netcodedev/LogicCircuit/ROADMAP_32BIT.md

# Roadmap: 32-Bit-RISC-V-SoC (`SOC_RV32`)

Ziel: ein 32-Bit-SoC mit dem Befehlssatz RISC-V RV32IM, gebaut aus denselben
Grundgattern wie `SOC_16B`, getrennt vom 8/16-Bit-Ökosystem (eigene
Schaltungen in `circuits/riscv/`, eigene Werkzeuge in `src/riscv/`, eigene
Programme in `programs/riscv/`). Gemeinsam genutzt werden nur die
breitenunabhängigen Grundbausteine in `src/circuits/` (`ADDER<W>`,
`REGISTER_R<W>`, `MUX_*_BUS<W>`, `PREFIX_LEVEL<W,D>`, ...). Der spätere
Ausbau auf 64 Bit (RV64I) wird mitgedacht: Bausteine mit Breitenparameter,
wo es geht.

## Entscheidungen (Phase 0, 2026-11-10)

Mit Ben besprochen und so angenommen:

1. **Befehlssatz:** RV32IM + Zicsr, ohne C-Erweiterung (16-Bit-Befehle
   machen Fetch und Decoder deutlich komplizierter; später optional).
2. **Register:** 32 × 32 Bit (volles RV32I, kein RV32E), x0 fest 0.
3. **Pipeline:** drei Stufen wie `SOC_16B` (Fetch | Execute | Memory) mit
   Forwarding, Load-Use-Stall und später Befehls-Cache. Das
   5-Stufen-Experiment des 16-Bit-SoC hat sich nicht gelohnt.
4. **Speicher:** ein gemeinsamer Bus (von Neumann) mit Byte-Adressen und
   Byte-Enables (`ByteEn[4]`). Fehlausgerichtete Zugriffe lösen eine
   Ausnahme aus (erlaubt laut Spezifikation, spart die Zerlegung in Hardware).
5. **Privilegien:** nur Machine-Mode mit minimalen CSRs (`mstatus`, `mie`,
   `mip`, `mtvec`, `mepc`, `mcause`, `mtval`, `mscratch`, `mcycle`,
   `minstret`, `misa`, `mhartid`) und einem Timer nach CLINT-Art
   (`mtime`/`mtimecmp`).
6. **Speicherkarte:** RAM ab `0x0000_0000`, Peripherie ab `0x1000_0000`
   (GPIO, Anzeige, UART, Timer), siehe unten.
7. **Toolchain:** eigener Assembler in Rust (läuft auch im Browser) und
   LLVM/Clang + lld als externe Abhängigkeit für C/Rust-Programme
   (`--target=riscv32 -march=rv32im_zicsr`).
8. **Chip-Flow:** zuerst weiter sky130 (direkter Vergleich mit `SOC_16B`),
   GF180MCU (wafer.space) als eigene spätere Phase.
9. **Namen:** `CPU_RV32` / `SOC_RV32` in `circuits/riscv/`.

Weitere Festlegungen (2026-11-10):

- **Halt:** `ebreak` hält die Maschine an (Ausgang `Halted`), statt eine
  Breakpoint-Ausnahme auszulösen – wie `HALT` beim 16-Bit-SoC.
- `wfi` und `fence` wirken wie `nop`.
- **Reset-Vektor** 0, `mtvec` nur direkt (Modus-Bits fest 0).
- `mcause` speichert Bit 31 und die Bits 3..0 (WLRL), `mepc`/`mtvec`
  Bits 31..2.
- Der Befehlssimulator zählt `mcycle` und `mtime` pro Befehl, die
  Schaltung pro Takt; Vergleiche lassen zeitabhängige Werte aus.

## Speicherkarte

| Adresse | Register | Zugriff |
|---|---|---|
| `0x0000_0000` | RAM (1 MiB im Runner, wiederholt sich) | lesen/schreiben |
| `0x1000_0000` | GPIO_OUT | lesen/schreiben |
| `0x1000_0004` | GPIO_IN | lesen |
| `0x1000_0008` | DISPLAY (8-stellige Hex-Anzeige) | lesen/schreiben |
| `0x1000_000C` | UART_DATA: schreiben sendet ein Byte, lesen holt das empfangene | lesen/schreiben |
| `0x1000_0010` | UART_STATUS: Bit 0 sendet gerade, Bit 1 Byte empfangen | lesen |
| `0x1000_0014` | UART_CTRL: Bit 0 Interrupt (extern) bei Empfang | lesen/schreiben |
| `0x1000_0018` | UART_DIV: Takte pro Bit - 1 (16 Bit, nach Reset 0) | lesen/schreiben |
| `0x1000_0020` / `_0024` | `mtime` (64 Bit, zählt Takte) | lesen/schreiben |
| `0x1000_0028` / `_002C` | `mtimecmp`; Timer-Interrupt, solange `mtime >= mtimecmp` | lesen/schreiben |

Die I/O-Register wiederholen sich alle 64 Byte im Bereich `0x1000_0000`–`0x1FFF_FFFF`
(IO_RV32 dekodiert nur die Adressbits 31..28 und 5..2). Ein Byte- oder
Halbwort-Store schreibt seine Bytes in ihre Spuren und 0 in die übrigen.
I/O-Lesezugriffe dauern zwei Takte (ein Wartetakt, das gelesene Register
wird zwischengespeichert), Schreibzugriffe einen.

## Phasen

### Phase 1 – Schneller Simulator (PR #6, 2026-11-10)
- [x] Flache Draht-Arrays, Flipflops als eingebaute Bausteine, topologische
      Sortierung: `SOC_16B` ~100 Hz → ~10 kHz

### Phase 2 – Werkzeuge in Rust (`src/riscv/`)
- [x] Befehlstabelle für Decoder, Encoder und Disassembler (`isa.rs`)
- [x] Assembler mit Pseudo-Befehlen und Direktiven (`asm.rs`), geprüft
      gegen LLVM (`clang --target=riscv32`), falls installiert
- [x] Befehlssimulator RV32IM + Zicsr mit Traps, Interrupts und der
      Peripherie der Speicherkarte (`sim.rs`)

### Phase 3 – Grundbausteine 32 Bit
- [x] Gemeinsam (mit Breitenparameter, in `src/circuits/`): `ADDER_KS5<W>`
      (Kogge-Stone, 5 Präfixstufen), `REG_FILE_32<W>` (x0 fest 0),
      `MUX_32_1_BUS<W>`, `DECODER_3_8`, `DECODER_5_32`
- [x] RISC-V-spezifisch (`circuits/riscv/`): `ALU_RV32` mit
      `SHIFTER_RV32`, `IMM_RV32`, `CONTROL_RV32` (Decoder, erkennt alle
      illegalen Befehle), `CSR_RV32`, `LSU_RV32` (Byte-Spuren),
      `MULDIV_RV32` (1 Bit pro Takt, 32 Schritte, Vorzeichen über Beträge)
- [x] Rust-Tests mit Zufallsvektoren gegen die Referenz (`src/riscv/tests.rs`)

### Phase 4 – CPU_RV32
- [x] Drei Stufen (Fetch \| Execute \| Memory), Forwarding aus der
      Memory-Stufe, Load-Use-Stall, ein Bus mit `Wait`
- [x] Traps (illegal, ecall, fehlausgerichtete Sprünge/Loads/Stores),
      Timer- und externer Interrupt, `mret`, `ebreak` hält an
- [x] M-Erweiterung über `MULDIV_RV32` (Execute wartet 32 Takte)
- [x] 101.020 NANDs (Registerdatei 50 %, CSRs 18 %, MulDiv 12 %),
      Logiktiefe 131 NAND-Stufen

### Phase 5 – SOC_RV32, Runner, Tests
- [x] `IO_RV32` (GPIO, Anzeige, UART mit `UART_TX`/`UART_RX`, `mtime`/
      `mtimecmp`), `SOC_RV32` mit Synchronizern und 8-stelliger Anzeige:
      123.293 NANDs
- [x] Runner `src/riscv/machine.rs` (RAM mit Byte-Enables, Wartezyklen,
      UART-Leitungen), `riscv asm/run/bench` in der CLI
- [x] Vergleich mit dem Befehlssimulator (`src/riscv/cpu_tests.rs`):
      Register, RAM, UART, Anzeige und GPIO gleich – gezielte Programme,
      Zufallsprogramme, langsamer Speicher, Timer- und UART-Interrupts
- [x] Programme in `programs/riscv/` (Assembler) und C über clang + lld
      (`programs/riscv/c/`: `crt0.s`, `link.ld`, `soc.h`)

### Phase 6 – Benchmarks, Viewer, Chip-Flow
- [x] `riscv bench` (`programs/riscv/bench/`), ohne Wartezyklen; das
      Ergebnis jedes Programms stimmt mit dem Befehlssimulator überein.
      Teuer sind der gemeinsame Bus (Loads/Stores halten den Fetch an) und
      die 33 Takte pro Multiplikation/Division.

| Programm | Befehle | Takte | CPI |
|---|---:|---:|---:|
| branch | 21.949 | 26.938 | 1,23 |
| calls | 20.713 | 31.563 | 1,52 |
| memory | 6.666 | 19.208 | 2,88 |
| muldiv | 6.904 | 112.262 | 16,26 |
| sieve (C) | 52.382 | 77.261 | 1,47 |
| sort | 7.897 | 13.730 | 1,74 |

- [x] Viewer: SOC_RV32 mit Beispielprogrammen, Listing mit
      Byte-Adressen, UART, Anzeige, GPIO
- [x] Simulation: SOC_RV32 läuft nativ mit etwa 6–18 kHz, im Browser
      mit etwa 1 kHz
- [ ] Chip-Flow (sky130) und Vergleich mit `SOC_16B`
- [x] `.clt`-Tests für alle RISC-V-Bausteine, `CPU_RV32` und `SOC_RV32`
      (für `verify-verilog`), aus dem Simulator erzeugt mit
      `cargo test --release --lib riscv::clt_gen -- --ignored`; CLT kann
      dafür ganze Busse setzen und prüfen (`SET A[31:0] 0x1234_5678`,
      `ASSERT S[31:0] -5`, `F[2:0] 0b101`)

### Phase 7 – Kürzerer kritischer Pfad
Gemessen als Logiktiefe in NAND-Stufen (wie `nands`), also ohne echte
Gatterlaufzeiten; ein sky130-Build steht noch aus.

| Schritt | Längster Pfad | `SOC_RV32` |
|---|---:|---:|
| Ausgangslage | 131 | 123.293 NANDs |
| Fehlausrichtung aus (rs1 + imm)[1:0], Branch über imm[1], `minstret` lädt bei Retire, CSR-Writes ohne ALU-Wartezeit | 98 | 123.329 |
| `MUX_2_1` als NAND-NAND (2 statt 4 Stufen, betrifft alle Schaltungen) | 84 | 100.945 |
| Eigener Vergleicher `BRANCH_RV32` aus rs1/rs2, Immediate-Formate direkt aus den Opcode-Bits, späte Branch-Exception am Ende der Exception-Kette | 69 | 102.206 |

- [x] Ergebnis: 131 → 69 Stufen (−47 %), 17 % weniger NANDs; `SOC_16B`
      sinkt durch den neuen Mux von 85 auf 64 Stufen
- [x] Die längsten Pfade sind jetzt ausgeglichen (65–69 Stufen): Decode →
      Load-Use-Stall → `XGo` → CSR-Schreiben, Branch-Vergleich → Redirect →
      `PC`, Trap → `mstatus`
- Shifter (17 Stufen) und Registerdatei-Lesen (14) liegen nicht mehr auf
  den längsten Pfaden; ein Umbau dort würde NANDs kosten, ohne den Takt zu
  heben
- [x] sky130-Build (`chip build SOC_RV32`, Basis-Blöcke, met5, 40 %):

  | | master | Phase 7 |
  |---|---:|---:|
  | fmax ohne `--optimize` (10 ns) | 28 MHz | 30 MHz |
  | fmax mit `--optimize` (7 ns) | 98 MHz | 131 MHz (+34 %) |
  | Transistoren (`--optimize`) | 188.897 | 192.901 |
  | + Shifter ohne Bit-Umkehr, `mtval` aus dem Addierer | | **134 MHz** (+37 %), 193.762 Transistoren |

  Ohne `--optimize` bestimmt der ungepufferte Fanout des Befehlsregisters
  (18 ns an einem Flipflop-Ausgang) den Takt. Mit `--optimize` lief der
  Pfad auf master über ALU-Ergebnis → Fehlausrichtung → Commit →
  `minstret`; jetzt über Registerdatei → Shifter → ALU-Mux → `mtval`.
  Auf Basis-Ebene wird `MUX_2_1` als `mux2`-Zelle exportiert, Schritt 3
  wirkt dort also nicht. Der Shifter (7 `mux2`-Stufen) lag in echten
  Zellen wieder auf dem kritischen Pfad; jetzt sind es Links- und
  Rechts-Shifter nebeneinander (5 Stufen, `SHIFT_STAGE_L`/`_R`), der
  ALU-Mux wählt. Danach sind die Pfade ausgeglichen: Branch-Vergleich →
  Trap/Redirect → `PC` (−0,48 ns) und Registerdatei → ALU → `ResultM`
  (−0,47 ns). Mehr Takt braucht einen Umbau der Pipeline (z. B. Redirect
  erst in der nächsten Stufe).

### Phase 8 – CPI und Fläche (aus der Untersuchung vom 11.11.2026)
Vier Recherche-Agenten haben Pipeline, Befehls-Cache, MulDiv/Sprungvorhersage
und Fläche untersucht (Prototypen). Umgesetzt sind die billigen Gewinne:

- [x] `INC_KS5<W>` (Inkrementierer) statt Addierer für `mcycle`/`minstret`,
      `mtime`, die Vorzeichen in `MULDIV_RV32` und PC + 4; `CMP_KS5<W>`
      (nur Übertrag) für `BRANCH_RV32` und `mtime >= mtimecmp`
- [x] `MULDIV_RV32` mit 2 Bit pro Takt (18 statt 34 Takte)
- [x] Statische Sprungvorhersage im Fetch: Rückwärtssprünge genommen,
      Vorwärtssprünge nicht, `jal` immer; Execute prüft nur die Richtung

| Programm | CPI vorher | CPI jetzt |
|---|---:|---:|
| branch | 1,23 | 1,02 |
| calls | 1,52 | 1,43 |
| memory | 2,88 | 2,04 |
| muldiv | 16,26 | 8,78 |
| sieve (C) | 1,47 | 1,26 |
| sort | 1,74 | 1,45 |

- [x] `SOC_RV32`: 102.406 → 99.430 NANDs; sky130 (`--optimize`, 7 ns):
      134 → 135 MHz, 193.762 → 183.531 Transistoren (−5 %), Die 689 → 667 µm
- [x] `--lib hs` (schnelle Zellen, Stand Phase 7): 143 MHz bei Die 787 µm
- [x] Registerdatei schon im Fetch lesen: rs1/rs2 landen mit dem Befehl in
      `OpA`/`OpB` (ein Write auf derselben Flanke wird umgeleitet, `HazR`
      merkt sich, was die Memory-Stufe noch weiterreichen muss)
- [x] Vor-Dekodierung im Fetch: `DECODE_RV32` (`CONTROL_RV32` + `IMM_RV32`
      in Registern), Execute bekommt alle Steuersignale aus Flipflops
- [x] `MTIP` registriert; I/O-Lesezugriffe mit einem Wartetakt (gelesenes
      Register zwischengespeichert), damit der I/O-Lese-Mux nicht vor dem
      Dekoder liegt; `Redirect` ohne die späte Branch-Exception
- [x] Ergebnis: 69 → 52 NAND-Stufen (`SOC_RV32`), 99.430 → 106.760 NANDs,
      CPI gleich (sieve 1,26 → 1,27 durch die I/O-Wartetakte); sky130
      (`--optimize`): 135 → **170 MHz** (+26 %, Ziel 5 ns;
      bei 6 ns wird das Ziel mit 167 MHz genau erreicht), 183.531 →
      193.292 Transistoren, Die 667 → 684 µm. Der längste Pfad ist jetzt
      ein Schritt von `MULDIV_RV32` (Ir → Radix-4-Schritt → `LoReg`),
      danach Forwarding → Branch-Vergleich → `PC`
- Weitere Prototypen (noch nicht übernommen): Registerdatei aus Latches
  (−27k NANDs, braucht Latch-Zellen und Timing-Constraints im Export),
  Befehls-Cache mit 32 Wörtern (+54k NANDs, bei 3 Wartetakten 2–3,5× schneller). Cache, Vorhersage und frühes
  Register-Lesen teilen sich den Fetch-Pfad: zusammen brauchen sie
  Vor-Dekodier-Bits im Cache oder eine eigene Fetch-Stufe.

### Später
- [ ] Befehls-Cache
- [ ] Schnellerer Multiplizierer (4 Bit pro Takt) und Division mit frühem Ende
- [ ] GF180MCU-Flow (wafer.space)
- [ ] RV64I
