netcodedev/LogicCircuit/src/main.rs

use clap::Parser;
use std::path::{Path, PathBuf};

use logic_circuit::cldl::CircuitBuilder;
use logic_circuit::clt::{CircuitTester, TestSummary}; // Import TestSummary
use logic_circuit::cldl::FlatLevel;
use logic_circuit::export::verilog::{CellLib, VerilogOptions, export_verilog};
use logic_circuit::export::verify_with_iverilog;
use logic_circuit::chip::{self, BuildOptions, RunMetrics};
use logic_circuit::isa::Isa;
use logic_circuit::isa::sim16::Cpu16;
use logic_circuit::{clt, machine, riscv};

#[derive(clap::ValueEnum, Clone, Copy, Debug)]
enum Level {
    /// Basic blocks (NOT, AND, OR, XOR, ...) as standard cells
    Basic,
    /// Everything as 2-input NAND cells
    Nand,
}

impl From<Level> for FlatLevel {
    fn from(l: Level) -> Self {
        match l {
            Level::Basic => FlatLevel::Basic,
            Level::Nand => FlatLevel::Nand,
        }
    }
}

#[derive(clap::ValueEnum, Clone, Copy, Debug)]
enum LibArg {
    /// sky130_fd_sc_hd: high density
    Hd,
    /// sky130_fd_sc_hs: high speed
    Hs,
}

#[derive(clap::ValueEnum, Clone, Copy, Debug)]
enum Cells {
    /// sky130_fd_sc_hd standard cells (for OpenROAD)
    Sky130,
    /// sky130_fd_sc_hs standard cells: high speed, larger
    Sky130Hs,
    /// Self-contained LC_* cell models (for Icarus Verilog / Verilator)
    Generic,
}

// --- Command Line Argument Parsing ---
#[derive(Parser, Debug)]
#[command(author, version, about, long_about = None)]
struct Args {
    #[command(subcommand)]
    command: Option<Commands>,

    /// Optional path to a directory containing additional .cldl circuit
    /// definitions AND/OR .clt test files. Searched recursively.
    /// If provided, definitions augment/override embedded ones, and
    /// the 'test' command ONLY runs tests from this directory.
    /// If not provided, 'test' command runs tests from src/circuits/.
    #[arg(short = 'd', long, value_name = "DIR")]
    directory: Option<PathBuf>,
}

#[derive(clap::Subcommand, Debug)]
enum Commands {
    /// Run circuit tests (.clt files).
    /// Runs tests either from the directory specified by -d
    /// or from src/circuits/ if -d is not provided.
    Test {
        /// Build every circuit from NAND gates only (the *_NAND definitions
        /// in place of the built-in gates), as a cross-check.
        #[arg(long)]
        nand: bool,
    },
    Export {
        #[arg(value_name = "COMPONENT_NAME")]
        component_name: String,
    },
    /// Assemble a program (.asm) and run it on a CPU circuit.
    /// Loads ./circuits automatically if -d is not given.
    Run {
        #[arg(value_name = "PROGRAM")]
        program: PathBuf,
        /// Circuit to run on (needs PC, CLK and Instruction or a memory bus).
        /// Default: COMPUTER_16B for programs in a directory named "16",
        /// SOC_16B in one named "soc", else COMPUTER_8B. The circuit's ports
        /// select the instruction set.
        #[arg(long)]
        top: Option<String>,
        /// Value on the input port `In` (decimal or 0x hex).
        #[arg(long, default_value = "0", value_parser = parse_word)]
        input: u16,
        /// Stop after this many instructions if the program does not HALT.
        #[arg(long, default_value_t = 10_000)]
        max_steps: usize,
        /// Print every executed instruction.
        #[arg(long)]
        trace: bool,
        /// Wait states per memory access, for CPUs with IWait/DWait ports
        /// (COMPUTER_16B_PIPE3); 0 = memories answer at once.
        #[arg(long, default_value_t = 0)]
        mem_latency: usize,
        /// Text to send to the UART receive line (SOC_16B); `\n` is a newline.
        #[arg(long, default_value = "")]
        uart_in: String,
    },
    /// Run the benchmarks in programs/bench: instructions on the
    /// instruction-level simulator, clocks on each 16-bit computer.
    /// Loads ./circuits automatically if -d is not given.
    Bench {
        /// Computers to run on, comma-separated.
        #[arg(long, default_value = "COMPUTER_16B,COMPUTER_16B_PIPE3,SOC_16B")]
        top: String,
        /// Wait states per memory access (see run --mem-latency).
        #[arg(long, default_value_t = 0)]
        mem_latency: usize,
        /// Only the instruction-level simulator (fast).
        #[arg(long)]
        isa_only: bool,
        /// Also show where the clocks go (computers with CPU_16B_SOC):
        /// executed instructions and the clocks lost, by cause.
        #[arg(long)]
        stalls: bool,
    },
    /// Count the NAND gates a circuit is built from, broken down by part.
    /// Without a name, lists every known circuit.
    /// Loads ./circuits automatically if -d is not given.
    Nands {
        #[arg(value_name = "COMPONENT_NAME")]
        component_name: Option<String>,
        /// How many hierarchy levels of parts to break down.
        #[arg(long, default_value_t = 1)]
        depth: usize,
    },
    /// Export a circuit as structural gate-level Verilog.
    /// Loads ./circuits automatically if -d is not given.
    ExportVerilog {
        #[arg(value_name = "COMPONENT_NAME")]
        component_name: String,
        #[arg(long, value_enum, default_value_t = Level::Basic)]
        level: Level,
        #[arg(long, value_enum, default_value_t = Cells::Sky130)]
        cells: Cells,
        /// Keep flip-flops as our latch gates instead of flip-flop cells.
        #[arg(long)]
        keep_latches: bool,
        /// Map 2:1 multiplexers (MUX_2_1) to multiplexer cells instead of
        /// their gates (basic level only; chip builds always do this).
        #[arg(long)]
        mux_cells: bool,
        /// Output file (default: <COMPONENT_NAME>.v).
        #[arg(short, long)]
        output: Option<PathBuf>,
        /// Also write a TSV mapping Verilog names back to wire keys / parts.
        #[arg(long, value_name = "FILE")]
        names: Option<PathBuf>,
    },
    /// The RISC-V SoC (SOC_RV32): assemble, run, benchmark.
    /// Loads ./circuits automatically if -d is not given.
    Riscv {
        #[command(subcommand)]
        command: RiscvCommand,
    },
    /// Chip layout: place and route with OpenROAD (Docker) and report.
    /// Loads ./circuits automatically if -d is not given.
    Chip {
        #[command(subcommand)]
        command: ChipCommand,
    },
    /// Check exported netlists against the .clt tests with Icarus Verilog.
    /// Without a name, checks every circuit that has tests.
    VerifyVerilog {
        #[arg(value_name = "COMPONENT_NAME")]
        component_name: Option<String>,
        #[arg(long, value_enum, default_value_t = Level::Basic)]
        level: Level,
        #[arg(long)]
        keep_latches: bool,
        /// Start every cell unknown (x), as after power-on, instead of at the
        /// simulator's state after building: passes only for suites whose
        /// tests reset first (e.g. SOC_16B, CPU_16B_SOC, CPU_16B_PIPE3).
        #[arg(long)]
        x_init: bool,
        /// Map 2:1 multiplexers to multiplexer cells, as chip builds do.
        #[arg(long)]
        mux_cells: bool,
    },
}
#[derive(clap::Subcommand, Debug)]
enum RiscvCommand {
    /// Print the listing of an assembly program (address, word, source).
    Asm {
        #[arg(value_name = "PROGRAM")]
        program: PathBuf,
    },
    /// Run a program (.s, or .c with clang + lld) on SOC_RV32 or the
    /// instruction-level simulator.
    Run {
        #[arg(value_name = "PROGRAM")]
        program: PathBuf,
        /// Circuit with CPU_RV32's bus (default SOC_RV32).
        #[arg(long)]
        top: Option<String>,
        /// Run on the instruction-level simulator instead of a circuit.
        #[arg(long)]
        iss: bool,
        /// Stop after this many clocks (instructions with --iss).
        #[arg(long, default_value_t = 1_000_000)]
        max: u64,
        /// Print the PC and instruction every clock.
        #[arg(long)]
        trace: bool,
        /// Wait states per memory access.
        #[arg(long, default_value_t = 0)]
        mem_latency: usize,
        /// Text to send to the UART; `\\n` is a newline.
        #[arg(long, default_value = "")]
        uart_in: String,
        /// Value on the GPIO inputs (decimal or 0x hex).
        #[arg(long, default_value = "0", value_parser = parse_u32)]
        gpio_in: u32,
    },
    /// Run the programs in programs/riscv/bench: instructions on the
    /// instruction-level simulator, clocks on each circuit.
    Bench {
        #[arg(long, default_value = "SOC_RV32")]
        top: String,
        #[arg(long, default_value = "programs/riscv/bench")]
        dir: PathBuf,
        #[arg(long, default_value_t = 0)]
        mem_latency: usize,
    },
}

#[derive(clap::Subcommand, Debug)]
enum ChipCommand {
    /// Export as sky130 netlist, then floorplan, place, clock tree and route.
    /// Results go to chip/<NAME>/<run>/ (run name from the options).
    Build {
        #[arg(value_name = "COMPONENT_NAME")]
        component_name: String,
        #[arg(long, value_enum, default_value_t = Level::Basic)]
        level: Level,
        #[arg(long)]
        keep_latches: bool,
        /// Highest metal layer for routing, power grid and pins.
        #[arg(long, default_value = "met5", value_parser = ["met2", "met3", "met4", "met5"])]
        max_layer: String,
        /// Clock period in ns for timing analysis.
        #[arg(long, default_value_t = 10.0)]
        clock_period: f64,
        /// Core utilisation in percent.
        #[arg(long, default_value_t = chip::DEFAULT_UTIL)]
        util: u32,
        /// Fixed die size in um instead of --util: "200" (square) or "160x225".
        #[arg(long, value_parser = parse_die_size)]
        die_size: Option<(f64, f64)>,
        /// Let OpenROAD buffer and resize cells (changes the netlist).
        #[arg(long)]
        optimize: bool,
        /// Access time in ns of the instruction and data memories outside the
        /// chip (PC -> Instruction, MemAddr -> MemDataIn, Addr -> DataIn);
        /// 0 = ideal memories.
        #[arg(long, default_value_t = 0.0)]
        mem_delay: f64,
        /// Standard cell library: hd (high density) or hs (high speed: larger
        /// cells, faster; the run name gets "-hs").
        #[arg(long, value_enum, default_value_t = LibArg::Hd)]
        lib: LibArg,
    },
    /// Combine DEF, LEF and cell GDS of a run into one layout file
    /// (default <run>/layout.bin) and check it: every exported cell placed,
    /// every signal net connected.
    Extract {
        #[arg(value_name = "COMPONENT_NAME")]
        component_name: String,
        /// Run to extract (default: basic-met5, else the first run).
        #[arg(long)]
        run: Option<String>,
        /// Output file.
        #[arg(short, long)]
        output: Option<PathBuf>,
        /// Also write the layout as JSON (large; for debugging).
        #[arg(long)]
        json: bool,
    },
    /// Draw the layout as an image: top view of chosen layers, or an
    /// isometric view of the stack (--iso). SVG or PNG.
    Render {
        #[arg(value_name = "COMPONENT_NAME")]
        component_name: String,
        #[arg(long)]
        run: Option<String>,
        /// Comma-separated layers (e.g. met1,met2) or "all".
        #[arg(long)]
        layers: Option<String>,
        /// Isometric view of the layer stack instead of the top view.
        #[arg(long)]
        iso: bool,
        /// Include the power grid (VDD/VSS).
        #[arg(long)]
        power: bool,
        /// Isometric: microns between layers.
        #[arg(long, default_value_t = 4.0)]
        explode: f64,
        /// Isometric: vertical exaggeration.
        #[arg(long, default_value_t = 4.0)]
        zscale: f64,
        /// Image width in pixels.
        #[arg(long, default_value_t = 1600)]
        width: u32,
        /// svg or png (default: from the output file name, else svg).
        #[arg(long, value_parser = ["svg", "png"])]
        format: Option<String>,
        /// Output file (default: <run>/<NAME>-top.svg / -iso.svg).
        #[arg(short, long)]
        output: Option<PathBuf>,
    },
    /// Place and route with our own tools (no OpenROAD/PDK): row placement
    /// with simulated annealing, maze routing with negotiated congestion.
    /// Writes chip/<NAME>/own-L<layers>/layout.bin.
    Route {
        #[arg(value_name = "COMPONENT_NAME")]
        component_name: String,
        /// Routing layers (2..5).
        #[arg(long, default_value_t = 3)]
        layers: i32,
        #[arg(long, value_enum, default_value_t = Level::Basic)]
        level: Level,
        #[arg(long)]
        keep_latches: bool,
        /// Core utilisation (0..1).
        #[arg(long, default_value_t = 0.7)]
        util: f64,
        /// Placement effort (annealing moves, relative).
        #[arg(long, default_value_t = 1.0)]
        effort: f64,
        /// Maximum negotiation iterations of the router.
        #[arg(long, default_value_t = 40)]
        iterations: usize,
    },
    /// Open the 3D view of a run in the browser (starts viz-serve if needed).
    View {
        #[arg(value_name = "COMPONENT_NAME")]
        component_name: String,
        #[arg(long)]
        run: Option<String>,
        #[arg(long, default_value_t = 8173)]
        port: u16,
        /// Only print the URL instead of opening a browser.
        #[arg(long)]
        no_open: bool,
    },
    /// Compare all runs of a circuit (or show one run in detail).
    Report {
        #[arg(value_name = "COMPONENT_NAME")]
        component_name: String,
        /// Show only this run, with its cell list.
        #[arg(long)]
        run: Option<String>,
        /// Print JSON instead of tables.
        #[arg(long)]
        json: bool,
    },
}
// --- End Command Line Args ---

fn main() {
    let args = Args::parse();

    // Step 1: Create builder (always loads all embedded circuits from src/circuits)
    println!("Initializing CircuitBuilder (loading embedded circuits)...");
    let mut builder = CircuitBuilder::new();

    // Step 2: Load additional circuits ONLY if -d is specified
    if let Some(dir_path) = args.directory.as_deref() {
        if !dir_path.exists() || !dir_path.is_dir() {
            // Make this a fatal error as the user explicitly provided a path
            eprintln!(
                "Error: Specified directory does not exist or is not a directory: {:?}",
                dir_path
            );
            std::process::exit(1);
        } else {
            println!(
                "Loading additional/override circuits from specified directory: {:?}",
                dir_path
            );
            if let Err(e) = builder.load_circuits_from_path(dir_path) {
                eprintln!("Error loading circuits from {:?}: {}", dir_path, e);
                std::process::exit(1); // Make it fatal
            }
        }
    }

    // The CPU circuits live in ./circuits, which is not embedded.
    if args.directory.is_none() && matches!(
        args.command,
        Some(
            Commands::Run { .. }
                | Commands::Bench { .. }
                | Commands::Nands { .. }
                | Commands::ExportVerilog { .. }
                | Commands::VerifyVerilog { .. }
                | Commands::Chip { .. }
                | Commands::Riscv { .. }
        )
    ) {
        let default_dir = Path::new("./circuits");
        if default_dir.is_dir() {
            if let Err(e) = builder.load_circuits_from_path(default_dir) {
                eprintln!("Error loading circuits from {:?}: {}", default_dir, e);
                std::process::exit(1);
            }
        }
    }

    // Step 3: Dispatch Command
    match args.command {
        Some(Commands::Test { nand }) => {
            let mut tester = CircuitTester::new();
            tester.nand = nand;
            let mut summary = TestSummary::new(); // Initialize summary
            let mut test_run_error = false;

            // Determine which directory to run tests in
            let test_dir_path = match args.directory.as_deref() {
                Some(p) => {
                    println!("Running tests specified in directory: {:?}", p);
                    p // Use the directory specified by -d
                }
                None => {
                    // -d not provided, default to src/circuits
                    let default_path = Path::new("./src/circuits");
                    println!("Running tests in default directory: {:?}", default_path);
                    default_path
                }
            };

            // Ensure the chosen test directory exists
            if !test_dir_path.exists() || !test_dir_path.is_dir() {
                eprintln!(
                    "Error: Test directory does not exist or is not a directory: {:?}",
                    test_dir_path
                );
                std::process::exit(1);
            }

            // Run tests using the determined path and the populated builder
            match tester.run_tests_in_dir(test_dir_path, &builder) {
                Ok(s) => summary = s, // Store the summary
                Err(e) => {
                    eprintln!("Test runner failed: {}", e);
                    test_run_error = true;
                    // summary remains default (0 passed, 0 failed)
                }
            }

            // Report final summary
            println!(
                "\nTest run finished: {} passed, {} failed.",
                summary.passed, summary.failed
            );
            if summary.failed > 0 || test_run_error {
                std::process::exit(1); // Exit with error code if tests failed or runner errored
            } else {
                println!("All specified tests passed! ✅");
                std::process::exit(0); // Exit successfully
            }
        }
        Some(Commands::Export { component_name }) => {
            println!("Exporting '{}' to DOT format...", component_name);
            
            // Generate the .dot string using the provided component name
            // Note: builder.export_to_dot will panic if the name is not found,
            // which is acceptable for this command-line tool.
            let dot_string = builder.export_to_dot(&component_name);
            
            // Create a dynamic filename, e.g., "ALU_4B.dot"
            let output_filename = format!("{}.dot", component_name);
            
            match std::fs::write(&output_filename, dot_string) {
                Ok(_) => println!("Successfully saved graph to '{}'", output_filename),
                Err(e) => eprintln!("Error saving .dot file: {}", e),
            }
        }
        Some(Commands::Run { program, top, input, max_steps, trace, mem_latency, uart_in }) => {
            let top = top.unwrap_or_else(|| {
                let in_dir = |name: &str| program.parent().is_some_and(|dir| dir.ends_with(name));
                if in_dir("16") {
                    "COMPUTER_16B"
                } else if in_dir("soc") {
                    "SOC_16B"
                } else {
                    "COMPUTER_8B"
                }
                .to_string()
            });
            run_program(&builder, &program, &top, input, max_steps, trace, mem_latency, &uart_in.replace("\\n", "\n"));
        }
        Some(Commands::Riscv { command }) => match command {
            RiscvCommand::Asm { program } => riscv::cli::asm(&program),
            RiscvCommand::Run { program, top, iss, max, trace, mem_latency, uart_in, gpio_in } => {
                let o = riscv::cli::RunOptions {
                    top,
                    iss,
                    max,
                    trace,
                    latency: mem_latency,
                    uart_in: uart_in.replace("\\n", "\n"),
                    gpio_in,
                };
                riscv::cli::run(&builder, &program, &o);
            }
            RiscvCommand::Bench { top, dir, mem_latency } => {
                let tops: Vec<&str> = top.split(',').map(str::trim).filter(|t| !t.is_empty()).collect();
                riscv::cli::bench(&builder, &dir, &tops, mem_latency);
            }
        },
        Some(Commands::Bench { top, mem_latency, isa_only, stalls }) => {
            let tops: Vec<&str> = if isa_only { Vec::new() } else { top.split(',').map(str::trim).collect() };
            run_bench(&builder, &tops, mem_latency, stalls);
        }
        Some(Commands::ExportVerilog { component_name, level, cells, keep_latches, mux_cells, output, names }) => {
            let opts = VerilogOptions {
                level: level.into(),
                cells: match cells {
                    Cells::Sky130 => CellLib::Sky130,
                    Cells::Sky130Hs => CellLib::Sky130Hs,
                    Cells::Generic => CellLib::Generic,
                },
                keep_latches,
                mux_cells,
            };
            let netlist = export_verilog(&builder, &component_name, &opts).unwrap_or_else(|e| {
                eprintln!("Error: {}", e);
                std::process::exit(1);
            });
            let path = output.unwrap_or_else(|| PathBuf::from(format!("{}.v", component_name)));
            if let Err(e) = std::fs::write(&path, &netlist.text) {
                eprintln!("Error writing {:?}: {}", path, e);
                std::process::exit(1);
            }
            let total: usize = netlist.cell_counts.values().sum();
            println!("\nWrote {} ({} cells)", path.display(), group_digits(total));
            for (cell, n) in &netlist.cell_counts {
                println!("  {:<28} {:>8}", cell, group_digits(*n));
            }
            if let Some(names_path) = names {
                let tsv: String = netlist.names.iter().map(|(v, k)| format!("{}\t{}\n", v, k)).collect();
                if let Err(e) = std::fs::write(&names_path, tsv) {
                    eprintln!("Error writing {:?}: {}", names_path, e);
                    std::process::exit(1);
                }
                println!("Wrote name map {}", names_path.display());
            }
        }
        Some(Commands::Chip { command }) => match command {
            ChipCommand::Build { component_name, level, keep_latches, max_layer, clock_period, util, die_size, optimize, mem_delay, lib } => {
                let opts = BuildOptions {
                    level: level.into(),
                    library: match lib {
                        LibArg::Hd => chip::Library::Hd,
                        LibArg::Hs => chip::Library::Hs,
                    },
                    keep_latches,
                    max_layer,
                    clock_period_ns: clock_period,
                    utilization: util,
                    die_size_um: die_size,
                    optimize,
                    mem_delay_ns: mem_delay,
                };
                println!("\nBuilding chip/{}/{} with OpenROAD …", component_name, opts.run_name());
                let started = std::time::Instant::now();
                match chip::build(&builder, &component_name, &opts, Path::new(".")) {
                    Ok(m) => {
                        println!("Done in {:.0} s.", started.elapsed().as_secs_f64());
                        print_chip_runs(&component_name, &[m]);
                    }
                    Err(e) => {
                        eprintln!("Error: {}", e);
                        std::process::exit(1);
                    }
                }
            }
            ChipCommand::Extract { component_name, run, output, json } => {
                if let Err(e) = chip_extract(&component_name, run.as_deref(), output, json) {
                    eprintln!("Error: {}", e);
                    std::process::exit(1);
                }
            }
            ChipCommand::Render { component_name, run, layers, iso, power, explode, zscale, width, format, output } => {
                let r = chip_render(&component_name, run.as_deref(), layers.as_deref(), iso, power, explode, zscale, width, format, output);
                if let Err(e) = r {
                    eprintln!("Error: {}", e);
                    std::process::exit(1);
                }
            }
            ChipCommand::Route { component_name, layers, level, keep_latches, util, effort, iterations } => {
                let opts = logic_circuit::pnr::Options {
                    level: level.into(),
                    keep_latches,
                    layers,
                    utilization: util,
                    effort,
                    max_iterations: iterations,
                    ..Default::default()
                };
                if let Err(e) = chip_route(&builder, &component_name, &opts) {
                    eprintln!("Error: {}", e);
                    std::process::exit(1);
                }
            }
            ChipCommand::View { component_name, run, port, no_open } => {
                if let Err(e) = chip_view(&component_name, run.as_deref(), port, no_open) {
                    eprintln!("Error: {}", e);
                    std::process::exit(1);
                }
            }
            ChipCommand::Report { component_name, run, json } => {
                let mut runs = chip::runs(Path::new("."), &component_name);
                if let Some(r) = &run {
                    runs.retain(|m| &m.run == r);
                }
                if runs.is_empty() {
                    eprintln!("No chip runs found for '{}' (chip build {} first).", component_name, component_name);
                    std::process::exit(1);
                }
                if json {
                    println!("{}", chip::to_json(&component_name, &runs));
                } else {
                    print_chip_runs(&component_name, &runs);
                    if run.is_some() {
                        print_chip_cells(&runs[0]);
                    }
                }
            }
        },
        Some(Commands::VerifyVerilog { component_name, level, keep_latches, x_init, mux_cells }) => {
            let opts = VerilogOptions { level: level.into(), cells: CellLib::Generic, keep_latches, mux_cells };
            verify_verilog(&builder, component_name.as_deref(), opts, x_init);
        }
        Some(Commands::Nands { component_name, depth }) => match component_name {
            Some(name) => print_nand_breakdown(&builder, &name, depth),
            None => print_nand_table(&builder),
        },
        None => {
            println!("\nNo command specified. Use 'test' or 'manual-test'.");
            println!("Use '-d <DIR>' to specify an additional directory for circuits and tests.");
            println!("Use '--help' for more options.");
        }
    }
}

/// Parses a 16-bit value given as decimal or `0x` hex.
fn parse_u32(text: &str) -> Result<u32, String> {
    match text.strip_prefix("0x").or_else(|| text.strip_prefix("0X")) {
        Some(hex) => u32::from_str_radix(hex, 16),
        None => text.parse(),
    }
    .map_err(|e| format!("expected a 32-bit number: {e}"))
}

fn parse_word(text: &str) -> Result<u16, String> {
    match text.strip_prefix("0x").or_else(|| text.strip_prefix("0X")) {
        Some(hex) => u16::from_str_radix(hex, 16),
        None => text.parse(),
    }
    .map_err(|e| format!("expected a 16-bit number: {e}"))
}

/// Runs every program in ./programs/bench on the instruction-level
/// simulator (instructions, expected Out) and on each computer in `tops`
/// (clocks; Out must match). Prints clocks and clocks per instruction.
fn run_bench(builder: &CircuitBuilder, tops: &[&str], latency: usize, stalls: bool) {
    let mut files: Vec<_> = std::fs::read_dir("./programs/bench")
        .map(|d| d.filter_map(|e| e.ok()).map(|e| e.path()).filter(|p| p.extension().is_some_and(|x| x == "asm")).collect())
        .unwrap_or_default();
    files.sort();
    if files.is_empty() {
        eprintln!("No benchmarks in ./programs/bench.");
        std::process::exit(1);
    }
    for top in tops {
        if builder.describe(top).is_none() {
            eprintln!("Circuit '{}' not found.", top);
            std::process::exit(1);
        }
    }
    print!("\n  {:<10} {:>8} {:>7}", "Benchmark", "Out", "Instr");
    for top in tops {
        print!("  {:>20}", top);
    }
    println!();
    let mut total_instr = 0u64;
    let mut hw_instr = 0u64;
    let mut total_clocks = vec![0usize; tops.len()];
    // Per computer: (benchmark, profile) and the sum, when --stalls.
    let mut profiles: Vec<Vec<(String, u64, logic_circuit::stalls::Profile)>> = vec![Vec::new(); tops.len()];
    let mut mismatch = false;
    for path in &files {
        let name = path.file_stem().unwrap().to_string_lossy();
        let src = std::fs::read_to_string(path).unwrap_or_default();
        let words = match Isa::Cpu16.assemble(&src) {
            Ok(p) => p.words,
            Err(e) => {
                eprintln!("{}:{}", path.display(), e);
                std::process::exit(1);
            }
        };
        let mut cpu = Cpu16::new(&words);
        cpu.run(10_000_000);
        total_instr += cpu.steps;
        if name.ends_with("_hw") {
            hw_instr += cpu.steps;
        }
        print!("  {:<10} {:>8} {:>7}", name, format!("0x{:04X}", cpu.out), cpu.steps);
        for (i, top) in tops.iter().enumerate() {
            // "*_hw" benchmarks need the multiply/divide unit (CPU_16B_SOC).
            if name.ends_with("_hw") && !has_muldiv(builder, top) {
                print!("  {:>20}", "–");
                continue;
            }
            let circuit = builder.build(top);
            let mut m = machine::Machine::new(&circuit).expect("not runnable");
            m.rom = words.clone();
            m.input = Some(0);
            m.latency = latency;
            m.reset(&circuit);
            let profile = if stalls { logic_circuit::stalls::run_profiled(&mut m, &circuit, 1_000_000) } else { None };
            let clocks = match &profile {
                Some(p) => p.clocks,
                None => m.run(&circuit, 1_000_000),
            };
            if let Some(p) = profile {
                profiles[i].push((name.to_string(), cpu.steps, p));
            }
            let out = machine::read_bus(&circuit, machine::OUT, 16) as u16;
            let ok = machine::halted(&circuit) && out == cpu.out;
            mismatch |= !ok;
            total_clocks[i] += clocks;
            let cell = format!("{} ({:.2}){}", clocks, clocks as f64 / cpu.steps as f64, if ok { "" } else { " ≠" });
            print!("  {:>20}", cell);
            use std::io::Write as _;
            let _ = std::io::stdout().flush();
        }
        println!();
    }
    print!("  {:<10} {:>8} {:>7}", "total", "", total_instr);
    for (i, c) in total_clocks.iter().enumerate() {
        let instr = if has_muldiv(builder, tops[i]) { total_instr } else { total_instr - hw_instr };
        print!("  {:>20}", format!("{} ({:.2})", c, *c as f64 / instr as f64));
    }
    println!();
    if !tops.is_empty() {
        println!("\n  Instr: instructions (instruction-level simulator); per computer: clocks (clocks per instruction)");
        println!("  –: needs the multiply/divide unit (CPU_16B_SOC); totals leave these out");
    }
    for (top, runs) in tops.iter().zip(&profiles) {
        if !runs.is_empty() {
            print_stalls(top, runs);
        }
    }
    if mismatch {
        println!("\n≠: wrong Out or no HALT (expected the instruction-level result).");
        std::process::exit(1);
    }
}

/// Table of `bench --stalls`: per benchmark the clocks, the clocks in
/// which execute ran an instruction, and the lost clocks by cause.
fn print_stalls(top: &str, runs: &[(String, u64, logic_circuit::stalls::Profile)]) {
    use logic_circuit::stalls::{Loss, Profile};
    let mut total = Profile::default();
    for (_, _, p) in runs {
        total.add(p);
    }
    let instr: u64 = runs.iter().map(|r| r.1).sum();
    println!("\n  Where the clocks go on {top}:\n");
    print!("  {:<22}", "");
    for (name, _, _) in runs {
        print!(" {:>8}", name);
    }
    println!(" {:>8} {:>7}", "total", "share");
    let row = |label: &str, f: &dyn Fn(&Profile) -> usize| {
        print!("  {:<22}", label);
        for (_, _, p) in runs {
            print!(" {:>8}", f(p));
        }
        let t = f(&total);
        println!(" {:>8} {:>6.1}%", t, 100.0 * t as f64 / total.clocks.max(1) as f64);
    };
    row("clocks", &|p| p.clocks);
    row("instructions executed", &|p| p.executed);
    for loss in Loss::ALL {
        if total.lost(loss) > 0 {
            row(&format!("  {}", loss.label()), &|p| p.lost(loss));
        }
    }
    row("(branches predicted)", &|p| p.predicted);
    if total.executed as u64 != instr {
        println!("\n  Note: executed {} ≠ {} instructions of the instruction-level simulator.", total.executed, instr);
    }
}

/// True if `top` contains the multiply/divide unit (a CPU_16B_SOC).
fn has_muldiv(builder: &CircuitBuilder, top: &str) -> bool {
    fn find(builder: &CircuitBuilder, name: &str, depth: usize) -> bool {
        name == "MULDIV_16B"
            || depth > 0
                && builder.describe(name).is_some_and(|v| v.parts.iter().any(|p| find(builder, &p.part_type, depth - 1)))
    }
    find(builder, top, 3)
}

fn run_program(
    builder: &CircuitBuilder,
    path: &Path,
    top: &str,
    input: u16,
    max_steps: usize,
    trace: bool,
    latency: usize,
    uart_in: &str,
) {
    let source = std::fs::read_to_string(path).unwrap_or_else(|e| {
        eprintln!("Error reading {:?}: {}", path, e);
        std::process::exit(1);
    });
    if builder.describe(top).is_none() {
        eprintln!("Circuit '{}' not found (use -d to load its directory).", top);
        std::process::exit(1);
    }

    let circuit = builder.build(top);
    let Some(mut machine) = machine::Machine::new(&circuit) else {
        eprintln!("Circuit '{}' has no PC/Instruction/CLK ports.", top);
        std::process::exit(1);
    };
    let isa = machine.isa();
    let program = isa.assemble(&source).unwrap_or_else(|e| {
        eprintln!("{}:{}", path.display(), e);
        std::process::exit(1);
    });
    machine.rom = program.words;
    machine.input = Some(input);
    machine.latency = latency;
    machine.uart_in.extend(uart_in.bytes());
    machine.reset(&circuit);
    // Hex digits of the PC and of Out.
    let pc_digits = machine.pc_width().div_ceil(4);
    let out_width = machine::bus_width(&circuit, machine::OUT);
    let out_digits = out_width.div_ceil(4).max(1);
    println!("\nRunning {} ({} words) on {}", path.display(), machine.rom.len(), top);

    machine.fetch(&circuit);
    let mut steps = 0;
    let started = std::time::Instant::now();
    // Time spent printing the trace is not simulation time.
    let mut trace_time = std::time::Duration::ZERO;
    while steps < max_steps && !machine::halted(&circuit) {
        let pc = machine.pc(&circuit);
        let word = machine.word_at(pc);
        machine.step(&circuit);
        steps += 1;
        if trace {
            let t = std::time::Instant::now();
            println!(
                "  [{:4}] PC={:0pw$X}  {:04X}  {:<18} Out={:0ow$X}",
                steps,
                pc,
                word,
                isa.disassemble_at(&machine.rom, pc),
                machine::read_bus(&circuit, machine::OUT, out_width),
                pw = pc_digits,
                ow = out_digits,
            );
            trace_time += t.elapsed();
        }
    }
    let elapsed = started.elapsed().saturating_sub(trace_time);

    let out = machine::read_bus(&circuit, machine::OUT, out_width);
    if machine::halted(&circuit) {
        println!("Halted after {} instructions at PC={:0w$X}.", steps, machine.pc(&circuit), w = pc_digits);
    } else {
        println!("Stopped after {} instructions (no HALT, see --max-steps).", steps);
    }
    println!("Out = 0x{:0w$X} ({})", out, out, w = out_digits);
    if machine::bus_width(&circuit, "GpioOut") > 0 {
        println!("GpioOut = 0x{:04X}", machine::read_bus(&circuit, "GpioOut", 16));
    }
    if !machine.uart.is_empty() {
        println!("UART: {:?}", String::from_utf8_lossy(&machine.uart));
    }
    let secs = elapsed.as_secs_f64();
    let rate = if secs > 0.0 { steps as f64 / secs } else { 0.0 };
    let rate = if rate >= 1000.0 { format!("{:.1} kHz", rate / 1000.0) } else { format!("{:.0} Hz", rate) };
    println!("Time = {:.1} ms for {} instructions (≈ {})", secs * 1000.0, steps, rate);

    // Show the 7-segment outputs if the circuit has them (highest digit first).
    let digits: Vec<u32> = ["Seg3", "Seg2", "Seg1", "Seg0"]
        .iter()
        .filter(|name| circuit.has_wire(&format!("{}.0", name)))
        .map(|name| machine::read_bus(&circuit, name, 7))
        .collect();
    if !digits.is_empty() {
        let seg = |d: u32, i: u32, on: char| if (d >> i) & 1 == 1 { on } else { ' ' };
        let rows = [
            digits.iter().map(|&d| format!(" {} ", seg(d, 0, '_'))).collect::<Vec<_>>(),
            digits.iter().map(|&d| format!("{}{}{}", seg(d, 5, '|'), seg(d, 6, '_'), seg(d, 1, '|'))).collect(),
            digits.iter().map(|&d| format!("{}{}{}", seg(d, 4, '|'), seg(d, 3, '_'), seg(d, 2, '|'))).collect(),
        ];
        println!();
        for row in rows {
            println!("    {}", row.join(" "));
        }
    }
}

/// Formats a count with thousands separators, e.g. 12,345.
fn group_digits(n: usize) -> String {
    let digits = n.to_string();
    let mut out = String::new();
    for (i, c) in digits.chars().enumerate() {
        if i > 0 && (digits.len() - i) % 3 == 0 {
            out.push(',');
        }
        out.push(c);
    }
    out
}

fn print_nand_table(builder: &CircuitBuilder) {
    let mut rows: Vec<(String, usize)> = builder
        .circuit_names()
        .into_iter()
        .filter_map(|name| builder.nand_count(&name).map(|n| (name, n)))
        .collect();
    rows.sort_by(|a, b| b.1.cmp(&a.1).then_with(|| a.0.cmp(&b.0)));
    println!("\n  {:<20} {:>10}", "Circuit", "NANDs");
    for (name, n) in rows {
        println!("  {:<20} {:>10}", name, group_digits(n));
    }
}

fn print_nand_breakdown(builder: &CircuitBuilder, name: &str, depth: usize) {
    let Some(total) = builder.nand_count(name) else {
        eprintln!("Circuit '{}' not found (use -d to load its directory).", name);
        std::process::exit(1);
    };
    println!("\n{}: {} NANDs", name, group_digits(total));
    let built = builder.build(name);
    println!(
        "Simulated as {} built-in gates (NOT, AND, OR, XOR, ...; see src/circuit/gates.rs) and {} flip-flops",
        group_digits(built.gate_count()),
        group_digits(built.flop_count())
    );
    if let Some(d) = builder.logic_depth(name) {
        println!("Logic depth: {} NAND levels (longest path between inputs/flip-flops and outputs/flip-flops)", d);
    }
    println!();
    println!("  {:<32} {:<18} {:>10} {:>7}", "Part", "Type", "NANDs", "Share");
    print_parts(builder, name, total, 1, depth);
}

fn print_parts(builder: &CircuitBuilder, name: &str, total: usize, level: usize, depth: usize) {
    let Some(view) = builder.describe(name) else { return };
    let mut parts = view.parts;
    parts.sort_by(|a, b| b.nand_count.cmp(&a.nand_count));
    for part in parts {
        let label = format!("{}{}", "  ".repeat(level - 1), part.instance_name);
        let share = 100.0 * part.nand_count as f64 / total.max(1) as f64;
        println!(
            "  {:<32} {:<18} {:>10} {:>6.1}%",
            label,
            part.part_type,
            group_digits(part.nand_count),
            share
        );
        if level < depth && part.expandable {
            print_parts(builder, &part.part_type, total, level + 1, depth);
        }
    }
}

/// Collects all .clt test suites below the given directories.
fn collect_suites(dirs: &[&Path]) -> Vec<clt::CltTestSuite> {
    fn walk(dir: &Path, out: &mut Vec<clt::CltTestSuite>) {
        let Ok(entries) = std::fs::read_dir(dir) else { return };
        let mut paths: Vec<PathBuf> = entries.flatten().map(|e| e.path()).collect();
        paths.sort();
        for path in paths {
            if path.is_dir() {
                walk(&path, out);
            } else if path.extension().is_some_and(|e| e == "clt") {
                match std::fs::read_to_string(&path).map_err(|e| e.to_string()).and_then(|s| clt::parse_clt(&s)) {
                    Ok(file) => out.extend(file.suites),
                    Err(e) => eprintln!("Skipping {:?}: {}", path, e),
                }
            }
        }
    }
    let mut out = Vec::new();
    for dir in dirs {
        walk(dir, &mut out);
    }
    out
}

fn verify_verilog(builder: &CircuitBuilder, only: Option<&str>, opts: VerilogOptions, x_init: bool) {
    let suites: Vec<_> = collect_suites(&[Path::new("./src/circuits"), Path::new("./circuits")])
        .into_iter()
        .filter(|s| only.is_none_or(|n| s.circuit_name == n))
        .collect();
    if suites.is_empty() {
        eprintln!("No .clt tests found{}.", only.map(|n| format!(" for '{}'", n)).unwrap_or_default());
        std::process::exit(1);
    }
    let work = std::env::temp_dir().join("logiccircuit-verify");
    println!("\nVerifying exported netlists with Icarus Verilog (work dir {})", work.display());
    println!("  {:<20} {:>7} {:>9} {:>8}", "Circuit", "Checks", "Failures", "Skipped");
    let mut failed = 0;
    for suite in &suites {
        match verify_with_iverilog(builder, suite, opts, x_init, &work) {
            Ok(r) => {
                let mark = if r.failures.is_empty() { "✅" } else { "❌" };
                println!(
                    "  {:<20} {:>7} {:>9} {:>8}  {}",
                    suite.circuit_name,
                    r.checks,
                    r.failures.len(),
                    r.skipped.len(),
                    mark
                );
                for f in r.failures.iter().take(5) {
                    println!("      {}", f);
                }
                if !r.failures.is_empty() {
                    failed += 1;
                }
            }
            Err(e) => {
                println!("  {:<20} error: {}", suite.circuit_name, e.lines().next().unwrap_or(""));
                failed += 1;
            }
        }
    }
    if failed > 0 {
        println!("\n{} of {} suites failed.", failed, suites.len());
        std::process::exit(1);
    }
    println!("\nAll {} suites match our simulator.", suites.len());
}

fn print_chip_runs(name: &str, runs: &[RunMetrics]) {
    let fmt_f = |v: f64| group_digits(v.round() as usize);
    println!("\n{}\n", name);
    println!(
        "  {:<24} {:>13} {:>11} {:>8} {:>12} {:>10} {:>8} {:>4} {:>8} {:>9}",
        "Run", "Die (um)", "Logic um2", "Cells", "Transistors", "Wire um", "Vias", "DRC", "Slack", "fmax"
    );
    for r in runs {
        let cells = match r.exported_cells {
            Some(e) if e != r.logic_cells() => format!("{}*", group_digits(r.logic_cells())),
            _ => group_digits(r.logic_cells()),
        };
        println!(
            "  {:<24} {:>13} {:>11} {:>8} {:>12} {:>10} {:>8} {:>4} {:>8} {:>9}",
            r.run,
            format!("{:.0} x {:.0}", r.die_um.0, r.die_um.1),
            fmt_f(r.logic_area_um2),
            cells,
            group_digits(r.transistors),
            fmt_f(r.total_wire_um()),
            r.vias.map_or("-".into(), group_digits),
            r.drc_violations,
            r.worst_slack_ns.map_or("-".into(), |v| format!("{:.2} ns", v)),
            r.fmax_mhz().map_or("-".into(), |v| format!("{:.0} MHz", v)),
        );
    }
    if runs.iter().any(|r| r.exported_cells.is_some_and(|e| e != r.logic_cells())) {
        println!("  * more cells than exported: clock tree buffers (and buffers from --optimize)");
    }

    // Wire length per layer, one column per run.
    let layers: Vec<&str> = chip::LAYERS.to_vec();
    print!("\n  {:<6}", "Wire");
    for r in runs {
        print!(" {:>24}", r.run);
    }
    println!();
    for layer in layers {
        print!("  {:<6}", layer);
        for r in runs {
            let v = r.wire_um.get(layer).copied().unwrap_or(0.0);
            let share = 100.0 * v / r.total_wire_um().max(1.0);
            print!(" {:>24}", format!("{} um ({:.0}%)", fmt_f(v), share));
        }
        println!();
    }
}

fn print_chip_cells(run: &RunMetrics) {
    println!("\n  {:<36} {:>8}", "Cell", "Count");
    let mut cells: Vec<_> = run.cells.iter().collect();
    cells.sort_by(|a, b| b.1.cmp(a.1).then_with(|| a.0.cmp(b.0)));
    for (cell, n) in cells {
        println!("  {:<36} {:>8}", cell, group_digits(*n));
    }
}

fn chip_extract(name: &str, run: Option<&str>, output: Option<PathBuf>, json: bool) -> Result<(), String> {
    let root = Path::new(".");
    let run_dir = chip::resolve_run(root, name, run)?;
    println!("\nExtracting {} …", run_dir.display());
    let started = std::time::Instant::now();
    let (layout, checks) = chip::extract(root, &run_dir)?;
    let out = output.unwrap_or_else(|| run_dir.join("layout.bin"));
    let bytes = layout.write_binary();
    std::fs::write(&out, &bytes).map_err(|e| format!("{}: {}", out.display(), e))?;
    if json {
        let json_path = out.with_extension("json");
        std::fs::write(&json_path, layout.to_json()).map_err(|e| format!("{}: {}", json_path.display(), e))?;
        println!("Wrote {}", json_path.display());
    }
    println!(
        "Wrote {} ({:.1} MB) in {:.1} s",
        out.display(),
        bytes.len() as f64 / 1e6,
        started.elapsed().as_secs_f64()
    );

    let mapped = layout.nets.iter().filter(|n| n.key.is_some()).count();
    let signal = layout.nets.iter().filter(|n| !n.special).count();
    let with_path = layout.instances.iter().filter(|i| i.path.is_some()).count();
    println!(
        "\n  Die {:.1} x {:.1} um, {} cell masters, {} instances ({} from our netlist)",
        (layout.die.2 - layout.die.0) as f64 / layout.dbu_per_micron as f64,
        (layout.die.3 - layout.die.1) as f64 / layout.dbu_per_micron as f64,
        layout.masters.len(),
        group_digits(layout.instances.len()),
        group_digits(with_path)
    );
    println!(
        "  {} nets, {} signal nets mapped to simulator wires, {} routing shapes",
        group_digits(layout.nets.len()),
        group_digits(mapped),
        group_digits(layout.routes.len())
    );
    if mapped < signal {
        println!("  ({} signal nets without wire key, e.g. buffers from --optimize)", signal - mapped);
    }
    println!("\n  {:<8} {:>10}", "Layer", "Shapes");
    for (layer, n) in layout.shapes_per_layer() {
        println!("  {:<8} {:>10}", layer, group_digits(n));
    }

    println!("\n  Checks");
    let ok = |b: bool| if b { "✅" } else { "❌" };
    println!(
        "  {} cells placed: {} of {} exported",
        ok(checks.missing_cells.is_empty()),
        group_digits(checks.exported_cells - checks.missing_cells.len()),
        group_digits(checks.exported_cells)
    );
    println!(
        "  {} nets connected: {} of {}",
        ok(checks.open_nets.is_empty()),
        group_digits(checks.nets_checked - checks.open_nets.len()),
        group_digits(checks.nets_checked)
    );
    for n in checks.open_nets.iter().take(10) {
        println!("      open: {}", n);
    }
    for (what, list) in [
        ("unknown vias", &checks.unknown_vias),
        ("unknown layers", &checks.unknown_layers),
        ("masters without GDS", &checks.masters_without_gds),
    ] {
        if !list.is_empty() {
            println!("  ❌ {}: {}", what, list.join(", "));
        }
    }
    let failed = !checks.missing_cells.is_empty()
        || !checks.open_nets.is_empty()
        || !checks.unknown_vias.is_empty()
        || !checks.masters_without_gds.is_empty();
    if failed {
        return Err("layout checks failed".into());
    }
    Ok(())
}

#[allow(clippy::too_many_arguments)]
fn chip_render(
    name: &str,
    run: Option<&str>,
    layers: Option<&str>,
    iso: bool,
    power: bool,
    explode: f64,
    zscale: f64,
    width: u32,
    format: Option<String>,
    output: Option<PathBuf>,
) -> Result<(), String> {
    use logic_circuit::layout::{SKY130_STACK, render};
    let root = Path::new(".");
    let run_dir = chip::resolve_run(root, name, run)?;
    let layers = match layers {
        None => render::default_layers(iso),
        Some("all") => (0..SKY130_STACK.len()).filter(|&i| SKY130_STACK[i].kind != "well").collect(),
        Some(list) => list
            .split(',')
            .map(|n| {
                SKY130_STACK
                    .iter()
                    .position(|l| l.name == n.trim())
                    .ok_or_else(|| format!("unknown layer '{}' (known: {})", n, SKY130_STACK.iter().map(|l| l.name).collect::<Vec<_>>().join(", ")))
            })
            .collect::<Result<_, _>>()?,
    };
    let fmt = match format.as_deref() {
        Some("png") => render::Format::Png,
        Some(_) => render::Format::Svg,
        None if output.as_ref().is_some_and(|o| o.extension().is_some_and(|e| e == "png")) => render::Format::Png,
        None => render::Format::Svg,
    };
    let ext = if fmt == render::Format::Png { "png" } else { "svg" };
    let out = output.unwrap_or_else(|| run_dir.join(format!("{}-{}.{}", name, if iso { "iso" } else { "top" }, ext)));

    // OpenROAD runs are extracted from their DEF; our own router's runs only
    // have layout.bin.
    let has_def = std::fs::read_dir(&run_dir).map_err(|e| e.to_string())?.flatten().any(|e| e.path().extension().is_some_and(|x| x == "def"));
    let layout = if has_def {
        chip::extract(root, &run_dir)?.0
    } else {
        let data = std::fs::read(run_dir.join("layout.bin")).map_err(|e| e.to_string())?;
        logic_circuit::layout::Layout::from_binary(&data)?
    };
    let opts = render::RenderOptions { layers: layers.clone(), iso, power, explode, zscale, width_px: width, ..Default::default() };
    let started = std::time::Instant::now();
    let bytes = render::render(&layout, &opts, fmt)?;
    std::fs::write(&out, &bytes).map_err(|e| format!("{}: {}", out.display(), e))?;
    println!(
        "\nWrote {} ({:.1} MB, {} view, layers {}) in {:.1} s",
        out.display(),
        bytes.len() as f64 / 1e6,
        if iso { "isometric" } else { "top" },
        layers.iter().map(|&l| SKY130_STACK[l].name).collect::<Vec<_>>().join(","),
        started.elapsed().as_secs_f64()
    );
    Ok(())
}

fn chip_view(name: &str, run: Option<&str>, port: u16, no_open: bool) -> Result<(), String> {
    let root = Path::new(".");
    let run_dir = chip::resolve_run(root, name, run)?;
    let layout_file = run_dir.join("layout.bin");
    if !layout_file.is_file() {
        let (layout, _) = chip::extract(root, &run_dir)?;
        std::fs::write(&layout_file, layout.write_binary()).map_err(|e| e.to_string())?;
    }
    if !root.join("viz/web/pkg").is_dir() {
        return Err("the viewer is not built yet: run viz/build.sh first".into());
    }
    // Serve this run's layout under layouts/<NAME>.bin.
    let layouts = root.join("viz/web/layouts");
    std::fs::create_dir_all(&layouts).map_err(|e| e.to_string())?;
    std::fs::copy(&layout_file, layouts.join(format!("{}.bin", name))).map_err(|e| e.to_string())?;

    let url = format!("http://127.0.0.1:{}/index.html?mode=chip#{}", port, name);
    let running = std::net::TcpStream::connect(("127.0.0.1", port)).is_ok();
    let mut server = None;
    if !running {
        println!("Starting viz-serve on port {} …", port);
        let child = std::process::Command::new("cargo")
            .args(["run", "-q", "-p", "logic_circuit_viz", "--bin", "viz-serve", "--"])
            .arg(port.to_string())
            .spawn()
            .map_err(|e| format!("cannot start viz-serve: {}", e))?;
        server = Some(child);
        // Wait until it accepts connections.
        for _ in 0..600 {
            if std::net::TcpStream::connect(("127.0.0.1", port)).is_ok() {
                break;
            }
            std::thread::sleep(std::time::Duration::from_millis(100));
        }
    }
    println!("\n{} ({})\n{}", name, run_dir.display(), url);
    if !no_open {
        let opener = if cfg!(target_os = "macos") { "open" } else { "xdg-open" };
        if let Err(e) = std::process::Command::new(opener).arg(&url).status() {
            println!("(could not open a browser: {})", e);
        }
    }
    if let Some(mut child) = server {
        println!("viz-serve is running; Ctrl+C stops it.");
        let _ = child.wait();
    }
    Ok(())
}

/// "200" -> (200, 200), "160x225" -> (160, 225).
fn parse_die_size(s: &str) -> Result<(f64, f64), String> {
    let num = |v: &str| v.trim().parse::<f64>().map_err(|_| format!("invalid die size '{}'", s));
    match s.split_once(['x', 'X']) {
        Some((w, h)) => Ok((num(w)?, num(h)?)),
        None => num(s).map(|d| (d, d)),
    }
}

fn chip_route(builder: &CircuitBuilder, name: &str, opts: &logic_circuit::pnr::Options) -> Result<(), String> {
    println!("\nPlacing and routing {} with our own router ({} layers) …", name, opts.layers);
    let (layout, r) = logic_circuit::pnr::place_and_route(builder, name, opts)?;
    let dir = chip::chip_dir(Path::new("."), name).join(format!("own-L{}", opts.layers));
    std::fs::create_dir_all(&dir).map_err(|e| e.to_string())?;
    let out = dir.join("layout.bin");
    std::fs::write(&out, layout.write_binary()).map_err(|e| e.to_string())?;
    let die = layout.metrics.as_ref().map(|m| m["die_um"].clone()).unwrap_or_default();
    println!(
        "  {} cells, {} nets; grid {} x {} x {} (channel {} tracks); die {:.0} x {:.0} um",
        group_digits(r.cells),
        group_digits(r.nets),
        r.grid.0,
        r.grid.1,
        r.grid.2,
        r.channel_tracks,
        die[0].as_f64().unwrap_or(0.0),
        die[1].as_f64().unwrap_or(0.0)
    );
    if r.attempts > 1 {
        println!(
            "  needed {} attempts: utilisation lowered to {:.0} %, {} channel tracks",
            r.attempts,
            r.utilization * 100.0,
            r.channel_tracks
        );
    }
    println!(
        "  placement: HPWL {} -> {} tracks ({:.0} ms)",
        group_digits(r.hpwl_before as usize),
        group_digits(r.hpwl_after as usize),
        r.place_ms
    );
    let total: f64 = r.wire_per_layer.values().sum();
    println!(
        "  routing: {} iterations, {} um wire, {} vias ({:.0} ms)",
        r.iterations,
        group_digits(total as usize),
        group_digits(r.vias),
        r.route_ms
    );
    for (layer, um) in &r.wire_per_layer {
        println!("    {:<6} {:>10} um", layer, group_digits(*um as usize));
    }
    let ok = r.overflow == 0 && r.failed_nets.is_empty();
    println!(
        "  {} {} overlapping grid nodes, {} unrouted nets",
        if ok { "✅" } else { "❌" },
        r.overflow,
        r.failed_nets.len()
    );
    println!("Wrote {} (3D: chip view {} --run own-L{})", out.display(), name, opts.layers);
    if !ok {
        return Err("routing is not legal (try more layers, lower --util or more --iterations)".into());
    }
    Ok(())
}
