netcodedev/LogicCircuit/src/riscv/clt_gen.rs

//! Writes the `.clt` test suites of the RISC-V circuits and of the shared
//! blocks they introduced (ADDER_KS5, DECODER_3_8/5_32, MUX_32_1_BUS,
//! REG_FILE_32):
//!
//! ```text
//! cargo test --release --lib riscv::clt_gen -- --ignored
//! ```
//!
//! The expected values come from our simulator. The circuits themselves are
//! checked against Rust references and the instruction-level simulator
//! (`tests.rs`, `cpu_tests.rs`); the suites pin that behaviour down for
//! `test` and for `verify-verilog`, which runs them on the exported netlists.

use std::collections::HashMap;
use std::fmt::Write;
use std::path::Path;

use crate::circuit::Circuit;

use super::asm::assemble;
use super::isa::csr;
use super::machine::Machine;
use super::tests::builder;

/// The tests' xorshift generator, with u128 values for the suites.
struct Rng(super::tests::Rng);

impl Rng {
    fn new(seed: u64) -> Rng {
        Rng(super::tests::Rng(seed))
    }

    fn next(&mut self) -> u128 {
        self.0.next() as u128
    }

    fn word(&mut self) -> u128 {
        self.0.word() as u128
    }
}

const GENERATED: &str = "Generated by `cargo test --release --lib riscv::clt_gen -- --ignored`\n\
// from the simulator; the circuit is checked against Rust references and the\n\
// instruction-level simulator in src/riscv/tests.rs and cpu_tests.rs.";

/// One suite under construction: drives the circuit and writes the commands.
struct Suite {
    c: Circuit,
    /// Port name -> (width, is a bus).
    ports: HashMap<String, (usize, bool)>,
    outputs: Vec<String>,
    text: String,
    /// Last asserted value per output, for `check_changed`.
    last: HashMap<String, u128>,
}

impl Suite {
    fn new(name: &str) -> Suite {
        let b = builder();
        let view = b.describe(name).unwrap_or_else(|| panic!("{name} unknown"));
        let mut ports = HashMap::new();
        for p in view.inputs.iter().chain(&view.outputs) {
            ports.insert(p.name.clone(), (p.width.unwrap_or(1), p.width.is_some()));
        }
        let outputs = view.outputs.iter().map(|p| p.name.clone()).collect();
        let c = b.build(name);
        c.evaluate_stable();
        Suite { c, ports, outputs, text: format!("TESTS FOR {name} {{\n"), last: HashMap::new() }
    }

    fn fmt(&self, name: &str, width: usize, bus: bool, v: u128) -> String {
        if bus {
            format!("{name}[{}:0] 0x{v:0d$X}", width - 1, d = width.div_ceil(4))
        } else {
            format!("{name} {v}")
        }
    }

    fn port(&self, name: &str) -> (usize, bool) {
        *self.ports.get(name).unwrap_or_else(|| panic!("no port {name}"))
    }

    fn read(&self, name: &str, width: usize, bus: bool) -> u128 {
        if !bus {
            return self.c.get_wire_value(name) as u128;
        }
        (0..width).fold(0, |acc, i| acc | (self.c.get_wire_value(&format!("{name}.{i}")) as u128) << i)
    }

    fn test(&mut self, name: &str) {
        writeln!(self.text, "    TEST \"{name}\" {{").unwrap();
    }

    fn end(&mut self) {
        self.text += "    }\n\n";
    }

    fn comment(&mut self, line: &str) {
        writeln!(self.text, "        // {line}").unwrap();
    }

    /// SET inputs (values masked to their width) without evaluating.
    fn set(&mut self, values: &[(&str, u128)]) {
        let items: Vec<String> = values
            .iter()
            .map(|&(name, v)| {
                let (w, bus) = self.port(name);
                let v = if w >= 128 { v } else { v & ((1 << w) - 1) };
                if bus {
                    for i in 0..w {
                        self.c.set_input(&format!("{name}.{i}"), v >> i & 1 == 1);
                    }
                } else {
                    self.c.set_input(name, v == 1);
                }
                self.fmt(name, w, bus, v)
            })
            .collect();
        writeln!(self.text, "        SET {};", items.join(", ")).unwrap();
    }

    fn eval(&mut self) {
        self.c.evaluate_stable();
        self.text += "        EVAL;\n";
    }

    /// One rising and falling edge of CLK.
    fn clock(&mut self) {
        for v in [true, false] {
            self.c.set_input("CLK", v);
            self.c.evaluate_stable();
        }
        self.text += "        SEQ CLK 0 -> CLK 1 -> CLK 0;\n";
    }

    fn assert_line(&mut self, items: Vec<String>) {
        if !items.is_empty() {
            let line: Vec<String> = items.iter().map(|i| format!("ASSERT {i};")).collect();
            writeln!(self.text, "        {}", line.join(" ")).unwrap();
        }
    }

    /// ASSERT the given outputs (or internal buses `name:width`).
    fn check(&mut self, names: &[&str]) {
        let items = names
            .iter()
            .map(|n| {
                let (name, w, bus) = match n.split_once(':') {
                    Some((name, w)) => (name, w.parse().unwrap(), true),
                    None => {
                        let (w, bus) = self.port(n);
                        (*n, w, bus)
                    }
                };
                let v = self.read(name, w, bus);
                self.last.insert(name.to_string(), v);
                self.fmt(name, w, bus, v)
            })
            .collect();
        self.assert_line(items);
    }

    fn check_all(&mut self) {
        let outputs = self.outputs.clone();
        self.check(&outputs.iter().map(String::as_str).collect::<Vec<_>>());
    }

    /// ASSERT the outputs whose value changed since they were last asserted.
    fn check_changed(&mut self) {
        let outputs = self.outputs.clone();
        let changed: Vec<&str> = outputs
            .iter()
            .filter(|n| {
                let (w, bus) = self.port(n);
                self.last.get(*n) != Some(&self.read(n, w, bus))
            })
            .map(String::as_str)
            .collect();
        self.check(&changed);
    }

    fn write(mut self, path: &str, header: &str) {
        self.text.truncate(self.text.trim_end().len());
        self.text += "\n}\n";
        let file = format!("// {header}\n//\n// {GENERATED}\n\n{}", self.text);
        let full = Path::new(env!("CARGO_MANIFEST_DIR")).join(path);
        std::fs::write(&full, file).unwrap_or_else(|e| panic!("{path}: {e}"));
        eprintln!("wrote {path}");
    }
}

/// Combinational suite: `n` vectors from `inputs`, all outputs asserted.
fn combinational(name: &str, path: &str, header: &str, n: usize, mut inputs: impl FnMut(&mut Rng, usize) -> Vec<(&'static str, u128)>) {
    let mut s = Suite::new(name);
    let mut rng = Rng::new(0xC17 ^ name.len() as u64);
    let per_test = 10;
    for t in 0..n.div_ceil(per_test) {
        s.test(&format!("vectors {}..{}", t * per_test, ((t + 1) * per_test).min(n) - 1));
        for k in t * per_test..((t + 1) * per_test).min(n) {
            let v = inputs(&mut rng, k);
            s.set(&v);
            s.eval();
            s.check_all();
        }
        s.end();
    }
    s.write(path, header);
}

fn one_hot4(d: u128) -> u128 {
    1 << (d & 15)
}

/// A spread of real instruction words (every format) for the decoder.
fn sample_instructions() -> Vec<u32> {
    let src = "
        lui a0, 0x12345
        auipc t0, 0xFFFFF
        jal ra, . + 0x100
        jalr t1, -4(a2)
        beq a0, a1, . - 8
        bne s0, s1, . + 16
        blt t2, t3, . + 2048
        bge a5, a6, . - 4096
        bltu a0, zero, . + 4
        bgeu t5, t6, . + 12
        lb a0, -1(s0)
        lh a1, 2(s1)
        lw a2, 2047(sp)
        lbu a3, 0(t0)
        lhu a4, -2048(t1)
        sb a0, 3(s0)
        sh a1, -6(sp)
        sw ra, 12(sp)
        addi a0, a0, -1
        slti t0, t1, 5
        sltiu t2, t3, -1
        xori a6, a7, 0x7FF
        ori s2, s3, 1
        andi s4, s5, 0xF0
        slli s6, s7, 31
        srli s8, s9, 1
        srai s10, s11, 13
        add t3, t4, t5
        sub t6, a0, a1
        sll a2, a3, a4
        slt a5, a6, a7
        sltu s0, s1, s2
        xor s3, s4, s5
        srl s6, s7, s8
        sra s9, s10, s11
        or ra, sp, gp
        and tp, t0, t1
        mul a0, a1, a2
        mulh a3, a4, a5
        mulhsu a6, a7, s0
        mulhu s1, s2, s3
        div s4, s5, s6
        divu s7, s8, s9
        rem s10, s11, t3
        remu t4, t5, t6
        fence
        ecall
        ebreak
        mret
        wfi
        csrrw a0, mstatus, a1
        csrrs a2, mie, zero
        csrrc a3, mtvec, a4
        csrrwi a5, mscratch, 31
        csrrsi a6, mepc, 0
        csrrci a7, mcause, 7
        csrr t0, mcycle
        csrr t1, minstret
        csrr t2, mhartid
        csrw cycle, t0
        csrr t3, 0x7C0
    ";
    assemble(src).unwrap().words
}

/// The CSR addresses CSR_RV32 knows, plus some it does not.
fn csr_addresses() -> Vec<u16> {
    let mut v: Vec<u16> = csr::NAMES.iter().map(|&(_, n)| n).collect();
    v.extend([0x7C0, 0x302, 0xB03, 0xF11]);
    v
}

fn shared_blocks() {
    combinational("ADDER_KS5<32>", "src/circuits/adder/ADDER_KS5.clt", "Tests for ADDER_KS5<W> (Kogge-Stone adder) at W = 32", 40, |r, _| {
        vec![("A", r.word()), ("B", r.word()), ("Cin", r.next() & 1)]
    });
    combinational("DECODER_3_8", "src/circuits/decoder/DECODER_3_8.clt", "Tests for DECODER_3_8: every address, enabled and disabled", 16, |_, k| {
        vec![("A", k as u128 & 7), ("Enable", (k < 8) as u128)]
    });
    combinational("DECODER_5_32", "src/circuits/decoder/DECODER_5_32.clt", "Tests for DECODER_5_32: every address, plus some disabled", 40, |_, k| {
        vec![("A", (k as u128 * 7) & 31), ("Enable", (k < 32) as u128)]
    });
    combinational("MUX_32_1_BUS<4>", "src/circuits/mux/MUX_32_1_BUS.clt", "Tests for MUX_32_1_BUS<W> at W = 4 (input k = In[4k .. 4k+3]): every select", 32, |r, k| {
        // 128 input bits: four random words.
        vec![("In", r.next() | (r.next()) << 64), ("S", k as u128)]
    });

    // REG_FILE_32<32>: writes, reads of both ports, x0 stays 0.
    let mut s = Suite::new("REG_FILE_32<32>");
    let mut rng = Rng::new(32);
    let mut written = Vec::new();
    s.test("write every register, read it back on both ports");
    for r in 0..32u128 {
        let v = rng.word() | 1;
        written.push(v);
        s.set(&[("DataIn", v), ("WriteAddr", r), ("WriteEnable", 1), ("ReadAddrA", r), ("ReadAddrB", (r + 31) % 32)]);
        s.clock();
        s.eval();
        s.check_all();
    }
    s.end();
    s.test("disabled writes change nothing; random reads");
    for _ in 0..24 {
        let (a, b, w) = (rng.next() % 32, rng.next() % 32, rng.next() % 32);
        s.set(&[("DataIn", rng.word()), ("WriteAddr", w), ("WriteEnable", 0), ("ReadAddrA", a), ("ReadAddrB", b)]);
        s.clock();
        s.eval();
        s.check_all();
    }
    s.end();
    s.write("src/circuits/memory/REG_FILE_32.clt", "Tests for REG_FILE_32<W> (x0 hardwired 0) at W = 32");
}

fn riscv_blocks() {
    combinational("SHIFTER_RV32", "circuits/riscv/SHIFTER_RV32.clt", "Tests for SHIFTER_RV32: sll, srl, sra by every kind of amount", 60, |r, k| {
        vec![("A", r.word()), ("Amt", if k < 32 { k as u128 } else { r.next() % 32 }), ("Arith", r.next() & 1)]
    });
    combinational("ALU_RV32", "circuits/riscv/ALU_RV32.clt", "Tests for ALU_RV32: every function, with edge-case operands", 96, |r, k| {
        let f = (k % 8) as u128;
        vec![("A", r.word()), ("B", r.word()), ("F", f), ("Sub", ((k / 8) % 2) as u128), ("Arith", ((k / 16) % 2) as u128)]
    });
    combinational("BRANCH_RV32", "circuits/riscv/BRANCH_RV32.clt", "Tests for BRANCH_RV32: every branch condition, with equal and sign-crossing operands", 72, |r, k| {
        let f = [0u128, 1, 4, 5, 6, 7][k % 6];
        let a = r.word();
        let b = match (k / 6) % 4 {
            0 => a,
            1 => a ^ 0x8000_0000,
            _ => r.word(),
        };
        vec![("A", a), ("B", b), ("F", f)]
    });
    combinational("IMM_RV32", "circuits/riscv/IMM_RV32.clt", "Tests for IMM_RV32: every immediate format (and none)", 60, |r, k| {
        let fmt = k % 6;
        let w = r.next() as u32 as u128;
        vec![("Ir", w), ("FmtI", (fmt == 0) as u128), ("FmtS", (fmt == 1) as u128), ("FmtB", (fmt == 2) as u128), ("FmtU", (fmt == 3) as u128), ("FmtJ", (fmt == 4) as u128)]
    });
    let words = sample_instructions();
    let n = words.len() + 40;
    combinational("CONTROL_RV32", "circuits/riscv/CONTROL_RV32.clt", "Tests for CONTROL_RV32: one of every instruction, then random (mostly illegal) words", n, move |r, k| {
        let w = if k < words.len() { words[k] } else { r.next() as u32 | if k % 2 == 0 { 3 } else { 0 } };
        vec![("Ir", w as u128)]
    });
    // DECODE_RV32: the decode of each word loads on the clock edge (Load = 1)
    // and holds while Load = 0.
    let mut s = Suite::new("DECODE_RV32");
    let mut rng = Rng::new(0xDE);
    s.test("reset");
    s.set(&[("Reset", 1), ("Load", 0), ("Word", 0)]);
    s.clock();
    s.set(&[("Reset", 0)]);
    s.eval();
    s.check_all();
    s.end();
    let words = sample_instructions();
    for (t, chunk) in words.chunks(16).enumerate() {
        s.test(&format!("instructions {t}"));
        for &w in chunk {
            let load = rng.next() % 4 != 0;
            s.set(&[("Word", w as u128), ("Load", load as u128)]);
            s.clock();
            s.check_all();
        }
        s.end();
    }
    s.write("circuits/riscv/DECODE_RV32.clt", "Tests for DECODE_RV32: every instruction decoded into the registers, Load = 0 holds");
    combinational("LSU_RV32", "circuits/riscv/LSU_RV32.clt", "Tests for LSU_RV32: every size, signedness and address offset", 64, |r, k| {
        vec![("Rs2", r.word()), ("Word", r.word()), ("Size", (k % 3) as u128), ("Unsigned", ((k / 3) % 2) as u128), ("Addr", ((k / 6) % 4) as u128)]
    });

    // CSR_RV32: random reads, writes, traps and mret on the clock edge.
    let mut s = Suite::new("CSR_RV32");
    let mut rng = Rng::new(0xC5);
    let addrs = csr_addresses();
    s.test("reset");
    s.set(&[("Reset", 1)]);
    s.clock();
    s.set(&[("Reset", 0)]);
    s.eval();
    s.check_all();
    s.end();
    for t in 0..6 {
        s.test(&format!("random accesses {t}"));
        for _ in 0..12 {
            let a = addrs[rng.next() as usize % addrs.len()] as u128;
            let trap = rng.next() % 6 == 0;
            let mret = !trap && rng.next() % 6 == 0;
            s.set(&[
                ("CsrHi", one_hot4(a >> 8)),
                ("CsrMid", one_hot4(a >> 4)),
                ("CsrLo", one_hot4(a)),
                ("Op", 1 + rng.next() % 3),
                ("Src", rng.word()),
                ("CsrWrite", (!trap && rng.next() % 2 == 0) as u128),
                ("Trap", trap as u128),
                ("CauseInt", rng.next() & 1),
                ("CauseCode", rng.next() & 15),
                ("TrapPc", rng.word()),
                ("TrapVal", rng.word()),
                ("Mret", mret as u128),
                ("Retire", rng.next() & 1),
                ("MTIP", rng.next() & 1),
                ("MEIP", rng.next() & 1),
            ]);
            s.eval();
            s.check_all();
            s.clock();
            s.check_all();
        }
        s.end();
    }
    s.write("circuits/riscv/CSR_RV32.clt", "Tests for CSR_RV32: reads, writes (set/clear), traps, mret, counters, interrupts");

    // MULDIV_RV32: every operation, step by step until Done, then Consume.
    let mut s = Suite::new("MULDIV_RV32");
    let mut rng = Rng::new(0x3D);
    s.test("reset");
    s.set(&[("Reset", 1)]);
    s.clock();
    s.set(&[("Reset", 0)]);
    s.eval();
    s.check_all();
    s.end();
    let names = ["mul", "mulh", "mulhsu", "mulhu", "div", "divu", "rem", "remu"];
    for k in 0..16 {
        let f = k % 8;
        let (a, b) = match k {
            12 => (0x8000_0000u128, 0xFFFF_FFFFu128), // -2^31 / -1
            13 | 14 => (rng.word(), 0),      // by zero
            _ => (rng.word(), rng.word()),
        };
        s.test(&format!("{} 0x{a:08X}, 0x{b:08X}", names[f]));
        s.set(&[("A", a), ("B", b), ("F", f as u128), ("Start", 1), ("Consume", 0)]);
        s.clock();
        s.set(&[("Start", 0)]);
        s.eval();
        s.check(&["Busy", "Done"]);
        for _ in 0..40 {
            if s.c.get_wire_value("Done") {
                break;
            }
            s.clock();
            s.check(&["Busy", "Done"]);
        }
        s.check_all();
        s.set(&[("Consume", 1)]);
        s.clock();
        s.set(&[("Consume", 0)]);
        s.eval();
        s.check(&["Busy", "Done"]);
        s.end();
    }
    s.write("circuits/riscv/MULDIV_RV32.clt", "Tests for MULDIV_RV32: every M operation, with division by zero and overflow");

    // IO_RV32: register accesses, the UART line and the timer.
    let mut s = Suite::new("IO_RV32");
    let mut rng = Rng::new(0x10);
    s.test("reset");
    s.set(&[("Reset", 1), ("Rx", 1)]);
    s.clock();
    s.set(&[("Reset", 0)]);
    s.eval();
    s.check_all();
    s.end();
    let regs = [0u128, 1, 2, 3, 4, 5, 6, 8, 9, 10, 11, 7, 12];
    for t in 0..5 {
        s.test(&format!("random accesses {t}"));
        for _ in 0..16 {
            let reg = regs[rng.next() as usize % regs.len()];
            let write = rng.next() % 2 == 0;
            // UART_DIV small, mtimecmp low half small: the line and MTIP move.
            let data = match reg {
                6 => rng.next() % 4,
                10 | 11 => rng.next() % 64,
                _ => rng.word(),
            };
            let en = [0xF, 0xF, 0x1, 0x2, 0x4, 0x8, 0x3, 0xC][rng.next() as usize % 8];
            s.set(&[
                ("Addr", 0x1000_0000 | reg << 2 | if rng.next() % 4 == 0 { 0x40 } else { 0 }),
                ("WData", data),
                ("ByteEn", en),
                ("Write", write as u128),
                ("DataRead", (!write && rng.next() % 2 == 0) as u128),
                ("GpioIn", rng.word()),
                ("Rx", (rng.next() % 4 != 0) as u128),
            ]);
            s.eval();
            s.check_all();
            s.clock();
            s.check_all();
        }
        s.end();
    }
    s.test("not the I/O region");
    s.set(&[("Addr", 0x0000_0008), ("Write", 1), ("WData", 0x1234_5678), ("ByteEn", 0xF), ("DataRead", 0)]);
    s.eval();
    s.check_all();
    s.clock();
    s.set(&[("Addr", 0x2000_0008), ("Write", 0)]);
    s.eval();
    s.check_all();
    s.end();
    s.write("circuits/riscv/IO_RV32.clt", "Tests for IO_RV32: GPIO, display, UART registers and line, mtime/mtimecmp, byte lanes");
}

/// Program-flow suites: the harness plays the memory as `Machine` does,
/// clock by clock: SET the inputs it presents, ASSERT the outputs that
/// changed, one clock edge. At the end every output and the registers.
fn program_suite(top: &str, path: &str, header: &str, programs: &[(&str, &str)]) {
    let mut s = Suite::new(top);
    let soc = s.c.has_wire("Tx");
    for &(name, src) in programs {
        let words = assemble(src).unwrap_or_else(|e| panic!("{name}: {e}")).words;
        let mut m = Machine::new(&s.c, &words).unwrap();
        let inputs: Vec<&str> = if soc { vec!["DataIn", "Wait", "GpioIn", "Rx"] } else { vec!["DataIn", "Wait", "MTIP", "MEIP"] };
        s.test(name);
        for line in src.lines().map(str::trim).filter(|l| !l.is_empty()) {
            s.comment(line);
        }
        if soc {
            m.gpio_in = Some(0x0000_A5A5);
        }
        // The same inputs as the machine presents, written as SET.
        let present = |s: &mut Suite, m: &Machine| {
            m.serve(&s.c);
            let values: Vec<(&str, u128)> = inputs
                .iter()
                .map(|&n| {
                    let (w, bus) = s.port(n);
                    (n, s.read(n, w, bus))
                })
                .collect();
            s.set(&values);
        };
        s.set(&[("Reset", 1)]);
        for _ in 0..3 + if soc { 2 } else { 0 } {
            present(&mut s, &m);
            s.clock();
        }
        s.set(&[("Reset", 0)]);
        if soc {
            for _ in 0..2 {
                present(&mut s, &m);
                s.clock();
            }
        }
        s.last.clear();
        let mut after_halt = 0;
        for _ in 0..3000 {
            present(&mut s, &m);
            s.eval();
            s.check_changed();
            if m.halted(&s.c) {
                after_halt += 1;
                if !soc || after_halt > 60 {
                    break;
                }
            }
            m.clock(&s.c);
            s.text += "        SEQ CLK 0 -> CLK 1 -> CLK 0;\n";
        }
        assert!(m.halted(&s.c), "{name} did not halt");
        s.check_all();
        let prefix = if soc { "Cpu." } else { "" };
        let regs: Vec<String> = (1..32).map(|r| format!("{prefix}RegFile.R_{r}.Q:32")).collect();
        s.check(&regs.iter().map(String::as_str).collect::<Vec<_>>());
        s.end();
    }
    s.write(path, header);
}

const ALU_PROGRAM: &str = "
    li a0, 0x12345678
    li a1, -7
    add a2, a0, a1
    sub a3, a0, a1
    xor a4, a0, a1
    sra a5, a1, a0
    sltu a6, a1, a0
    li t1, 4
1:  addi t0, t0, 3
    addi t1, t1, -1
    bnez t1, 1b
    jal ra, 2f
    ebreak
2:  auipc s0, 1
    ret
";

const MEMORY_PROGRAM: &str = "
    la s0, data
    li a0, 0x8090A0B0
    sw a0, 0(s0)
    lw a1, 0(s0)
    add a2, a1, a1
    lb a3, 1(s0)
    lhu a4, 2(s0)
    sb a0, 5(s0)
    sh a0, 6(s0)
    lw a5, 4(s0)
    ebreak
    .align 3
data:
    .word 0, 0
";

const MULDIV_PROGRAM: &str = "
    li a0, -1234567
    li a1, 321
    mul a2, a0, a1
    mulh a3, a0, a1
    div a4, a0, a1
    remu a5, a0, a1
    div a6, a0, zero
    ebreak
";

const TRAP_PROGRAM: &str = "
    la t0, handler
    csrw mtvec, t0
    csrwi mscratch, 5
    ecall
    .word 0xFFFFFFFF
    lw a0, 2(zero)
    csrr a1, mcause
    ebreak
handler:
    csrr s0, mepc
    csrr s1, mtval
    addi s0, s0, 4
    csrw mepc, s0
    addi s2, s2, 1
    mret
";

const SOC_IO_PROGRAM: &str = "
    li s0, 0x10000000
    li t0, 0xCAFE1234
    sw t0, 8(s0)
    lw t1, 4(s0)
    sw t1, 0(s0)
    li t0, 'O'
    sb t0, 12(s0)
1:  lw t2, 16(s0)
    andi t2, t2, 1
    bnez t2, 1b
    li t0, 'K'
    sb t0, 12(s0)
    ebreak
";

const SOC_TIMER_PROGRAM: &str = "
    li s0, 0x10000000
    la t0, handler
    csrw mtvec, t0
    lw t1, 0x20(s0)
    addi t1, t1, 40
    sw zero, 0x2C(s0)
    sw t1, 0x28(s0)
    li t0, 0x80
    csrw mie, t0
    csrsi mstatus, 8
1:  beqz s1, 1b
    ebreak
handler:
    li t0, -1
    sw t0, 0x2C(s0)
    csrr s1, mcause
    mret
";

#[test]
#[ignore]
fn write_clt_files() {
    shared_blocks();
    riscv_blocks();
    let cpu = [("alu and branches", ALU_PROGRAM), ("loads and stores", MEMORY_PROGRAM), ("multiply and divide", MULDIV_PROGRAM), ("traps", TRAP_PROGRAM)];
    program_suite("CPU_RV32", "circuits/riscv/CPU_RV32.clt", "Program-flow tests for CPU_RV32 (one bus, the harness plays the memory)", &cpu);
    let soc = [("GPIO, display, UART", SOC_IO_PROGRAM), ("timer interrupt", SOC_TIMER_PROGRAM)];
    program_suite("SOC_RV32", "circuits/riscv/SOC_RV32.clt", "Program-flow tests for SOC_RV32 (the harness plays the external memory)", &soc);
}
