netcodedev/LogicCircuit/(commit log)

2025-10-24 Added D_LATCH and fixed SR_LATCH, Added instance names
    [main.rs]
2025-10-27 Added Automated Circuit testing
2025-10-27 Renamed 4-Bit Bitwise AND, OR, and XOR circuits with corresponding test suites
2025-10-28 Added Test Case for Cin
2025-10-30 Added PC_REGISTER circuit
2025-10-30 Add 4-to-16 Decoder circuit and test suite
2025-10-30 Add 16-to-1 4-Bit Multiplexer circuit and test suite
2025-10-31 Add 16x4 Register File circuit and test suite
2026-08-29 Fix wire fan-out aliasing and add 4-bit CPU with subtraction
    Resolve circuit wiring with a union-find over wire keys before any Wire is
    materialized, replacing the previous HashMap-key-reassignment aliasing. The
    old scheme could not represent fan-out: a source pin driving multiple loads
    would have an earlier alias silently severed by a later connection, so a
    control signal such as MemToReg never reached the datapath. Wiring is now
    order-independent and fan-out-safe by construction. Gate-add and INIT steps
    are recorded as an ordered event stream and replayed in the original DFS
    order, preserving init timing (e.g. registers reset to 0 before the write
    decoder that drives their Load line is bui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
2026-08-29 Close test-coverage gaps across circuit suites
    Add edge-case tests found missing during a full review of all circuit and
    test files. Test-only changes; no circuit or engine code touched.
    - CPU_4B: reg-reg SUB (asymmetric 10-5, proving A-B not B-A), ANDI/ORI/XORI,
    and reg-reg AND/OR/XOR against a distinct operand; each asserts decoded
    control signals, ALU Result bits, and the destination register.
    - DATAPATH_4B: two subtraction tests exercising the ALUCin=1 BInvert path,
    asserting Result bits and write-back (previously only flags were checked).
    - MUX_4B_16_1: full 16-input sweep (In[i]=i, every select code).
    - DECODER_4_16: full 16-address one-hot sweep.
    - MUX_4B_4_1: asymmetric patter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
2026-08-29 Add full 8-bit datapath stack (parts, register file, datapath, CPU)
    Widen the datapath to 8 bits by mirroring the verified 4-bit structures,
    in preparation for eventually scaling to 64-bit. Register addresses stay
    4-bit (16 registers) and control signals stay 1/2-bit, since only the data
    width changes.
    Combinational core:
    - ADDER_8B (8 chained FULL_ADDERs), AND_8B/OR_8B/XOR_8B (bit-sliced)
    - MUX_8B_2_1, MUX_8B_4_1, MUX_8B_16_1 (mux trees)
    - ALU_8B: pure A+B+Cin adder + logic units + result mux + gated Cout;
    8-bit zero flag built as AND(NOR4 low nibble, NOR4 high nibble)
    Sequential:
    - REGISTER_8B (8 DFLIP_FLOPs + load muxes, zeroing INIT)
    - REG_FILE_16x8 (15 registers + R0 hardwired 0, DE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
2026-11-09 Add WASM circuit visualizer
    Split the crate into lib + bin and add a per-level graph view of CLDL
    definitions (CircuitBuilder::describe, circuit_names, load_cldl_str).
    New viz/ workspace crate compiles the simulator to WASM and serves a
    browser viewer: ELK auto-layout per hierarchy level with drill-down,
    live wire values, input toggles and clock pulse, bus splitters/mergers
    and an optional per-bit striped bus rendering. viz-serve is a small
    std-only dev server; viz/build.sh builds the bundle.
2026-11-09 Add programmable CPU, assembler, 7-segment display and flat views
    Hardware (all NAND-based):
    - PC_8B program counter; CPU_8B gains PC, output register and
    JMP/BRZ/OUT/HALT (opcode 0 now HALTs; empty memory halts the CPU)
    - HEX_7SEG decoder and COMPUTER_8B (CPU + two-digit hex display)
    - Control unit exposes Halt/OutEnable/Jump/Branch; tests for all of it
    Rust:
    - isa.rs: single ISA table for assembler (labels, .word) and disassembler
    - machine.rs: runner that serves a ROM on PC -> Instruction
    - CLI `run` (trace, timing, ASCII display) and `nands` (NAND counts
    per part, --depth); example programs in programs/
    - CircuitBuilder::nand_count and flatten() to NAND or basic-block level,
    shari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
2026-11-09 Set up chip toolchain (roadmap phase 0)
    Pin the openroad/orfs image and add an OpenROAD Tcl flow (floorplan,
    taps, PDN, placement, CTS, routing with configurable top metal layer)
    plus a Docker wrapper. A sky130 smoke design routes DRC-clean with met5
    and met2 limits. Record the phase 0 decisions in ROADMAP.md.
2026-11-09 Add Verilog export with Icarus verification (roadmap phase 1)
    - export-verilog: structural netlist from flatten_until() at basic or
    NAND level, sky130_fd_sc_hd or self-contained generic LC_* cells,
    DFLIP_FLOP mapped to dfxtp/dfxbp unless --keep-latches; tie cells for
    undriven nets, buffers for shared output bits, TSV name map
    - verify-verilog: testbenches from .clt suites run in Icarus; generic
    cells start from our simulator's state and have 1-3 ps delays so
    latch loops settle. All 46 suites match in all four variants
    - viewer: "Verilog" download of the current level (WASM)
    - COMPUTER_8B (2,181 sky130 cells) routes DRC-clean in OpenROAD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
2026-11-09 Add chip build/report CLI with layer-aware flow (roadmap phase 2)
    - chip build: export sky130 netlist and run OpenROAD in the pinned
    container; runs live in chip/<NAME>/<run>/ named after the options
    - pnr.tcl: --max-layer limits routing, power grid (reduced met1+met2/met4
    grid below met5) and pins; optional repair_design/repair_timing;
    writes metrics (die, logic area, cells, transistors from the cell CDL)
    - chip report: comparison table of all runs, wire length per layer,
    cell list per run, JSON output
    - Record the layer-count experiment for COMPUTER_8B in ROADMAP.md
2026-11-09 Add layout extraction to own binary format (roadmap phase 3)
    - Own DEF/LEF/GDS readers (no extra crates): components, pins, power
    grid, routed nets incl. generated VIARULE vias, NDR widths, RECT
    patches; LEF layers/vias/macros; GDS cell geometry
    - chip extract: combine DEF + cell GDS + LEF into layout.bin (JSON
    header with layer stack, masters, instances, nets mapped to simulator
    wire keys; Int32 sections; masters stored once for instancing)
    - Checks: every exported cell placed, every signal net connects all its
    pins (union-find over shapes and vias); all COMPUTER_8B runs pass
    - Name tie/buffer cells in the export name map; platform cache in
    chip/.platform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
2026-11-09 Add 3D chip view to the viewer (roadmap phase 4)
    - "Chip 3D" view mode (three.js 0.170.0 via import map, loaded on
    demand): cell masters merged per layer and drawn as InstancedMesh for
    all placements, routing as instanced boxes with per-net colours
    - Layer toggles, explode, vertical exaggeration, top-down cut, power
    grid toggle; hover shows net/key/value or cell/path, click highlights
    a net through all layers; live simulation values light nets up
    - Layout metrics travel in the layout.bin header; viz/build.sh ships
    extracted layouts; drag and drop of layout.bin; URL parameters for
    mode and view settings; message when WebGL is unavailable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
2026-11-09 Add chip render and chip view to the CLI (roadmap phase 5)
    - chip render: top view of chosen layers or isometric stack (--iso,
    --explode, --zscale, --power) as SVG or PNG; shared polygon pipeline
    with SVG paths or an own scanline rasteriser (png crate for encoding)
    - chip view: copies the run's layout to the viewer, starts viz-serve if
    the port is free and opens the 3D view in the browser
2026-11-09 Add transistor view: NANDs as CMOS cells (roadmap phase 6)
    New "Transistoren" view mode draws every NAND of the current level as a
    CMOS cell (two parallel PMOS to VDD, two series NMOS to GND). Conducting
    transistors light up live (NMOS at gate 1, PMOS at gate 0); output node
    and gate wires show their values. Limited to 1,500 NANDs per level.
2026-11-09 Compare cell mappings and check TinyTapeout fit (roadmap phase 6)
    - chip build --die-size accepts WxH (rectangular dies)
    - Skip clock tree synthesis for --keep-latches (NO_CTS): without
    flip-flop cells CTS followed the clock into latch gates and crashed
    - ROADMAP: size comparison of all mappings (all-NAND = 32,256
    transistors) and TinyTapeout analysis: fits a 1x2 tile, needs a pin
    wrapper (proposal documented)
    [chip.rs, main.rs]
2026-11-09 Add own placer and router (roadmap phase 6)
    - src/pnr: row placement with simulated annealing (equal-width swaps in
    a shrinking neighbourhood, HPWL), maze routing on a 3D grid with
    alternating layer directions, tree routing via A* and PathFinder
    negotiated congestion; retries with wider channels / lower
    utilisation until legal
    - chip route --layers 2..5 writes chip/<NAME>/own-L<n>/layout.bin;
    chip view/render accept these runs (Layout::from_binary)
    - Browser: "Eigener Router" in the chip panel runs it in WASM
    - COMPUTER_8B routes legally with 2-5 layers; die grows from 154 um
    (5 layers) to 297 um (2 layers)
    [chip.rs, lib.rs, main.rs, mod.rs]
2026-11-09 Fix z-fighting between cell shapes, contacts and routing in 3D view
    Routing on li1/met1 shared its height with the cells' own shapes on the
    same layer, and contacts/vias touched the metal above and below with
    coplanar faces. Routing now uses a material with polygon offset and is
    2 % taller than the cell shapes; cut and contact layers are inset by
    3 % in height. Adds a ?zoom= URL parameter for close-up checks.
2026-11-09 Use flat shading in 3D view so mirrored cells shade like the rest
    Abutted rows share their power rails, so each rail exists twice, once
    from a normal (N) and once from a mirrored (FS) cell. Mirroring reverses
    the triangle winding; with smooth normals and double-sided materials
    three.js flips the normal of such "back" faces (it only corrects
    mirroring per object, not per instance), so the two coinciding rails were
    shaded differently and z-fought. Flat shading derives the normal from
    screen-space geometry and shades both alike.
2026-11-09 Build chip layouts from the browser
    - viz-serve API: GET /api/chip/runs, /api/chip/layout (extracts on
    demand), /api/chip/job; POST /api/chip/build runs chip::build +
    chip::extract in the background (one job at a time). POSTs need the
    X-LogicCircuit header, names and run ids are validated; server stays
    bound to 127.0.0.1
    - Chip panel: run selector (OpenROAD and own-router runs), build form
    (layers, level, utilisation, optimize, latches) with live progress;
    finished builds load automatically, running builds survive a reload
    - pnr.tcl: minimum 60 um core so tiny designs fit the power grid
2026-11-09 Add English README with 3D chip screenshot
    Describes the circuit and test languages, the 8-bit computer, Verilog
    export, the OpenROAD and own place-and-route flows and the browser
    viewer, with a screenshot of COMPUTER_8B in the Chip 3D view.
2026-11-09 Add loops and width parameters to CLDL
    FOR loops (nested, around PART and CONNECT, Rust-style ranges) and
    parametric definitions (CIRCUIT REGISTER<W>) are elaborated into plain
    definitions before planning, so build, flatten, views, NAND counts and
    the Verilog export work unchanged. Parametric instances are elaborated
    on first use and named like REGISTER<16>; indexed parts FA[i] become
    FA_3. .clt suites can test instances (TESTS FOR ADDER<16>).
    Elaboration errors report line and column. Adds ADDER<W>, REGISTER<W>
    and MUX_2_1_BUS<W> with tests for W = 4, 8, 16; they match the fixed
    4/8-bit blocks in NAND count and test vectors.
    Claude-S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
    [mod.rs]
2026-11-09 Add 16-bit building blocks for CPU_16B
    Parametric bus gates, 4:1 and 16:1 bus muxes, a register with
    synchronous reset and the 16-register file REG_FILE_16<W> (identical to
    the fixed 8-bit blocks at W=8). New 16-bit units: ALU_16B (operand
    conditioning covers every ALU function code; raw Z/N/C/V flags), a
    Kogge-Stone carry-lookahead adder, the barrel shifter SHIFTER_16B,
    FLAGS_16B, PC_16B with relative branches and PC+2, SP_16B and a
    four-digit hex display. All with .clt tests.
    'nands' now also prints the logic depth (longest NAND path between
    inputs/flip-flops and outputs/flip-flops). The lookahead adder cuts it
    from 67 to 14 levels; in a registered sky130 run it reaches 481 instead
    of 148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
    [main.rs]
2026-11-09 Define the 16-bit ISA and add CONTROL_UNIT_16B
    Fix the bit-level encoding of the CPU_16B instruction set in
    ROADMAP_16BIT.md and build its control unit: an opcode decoder plus
    enabled decoders for the SYS, ALU and LONG function codes, with every
    control signal an OR over decoder lines (OR_WIDE<G>). COND_16B evaluates
    the 16 ARM-style branch conditions from Z/N/C/V.
    Tests check all control signals for every opcode/function code
    (including reserved ones) and every condition against all flag
    combinations.
    Claude-Session: https://claude.ai/code/session_01RCZzuJPGmCjTHFdjFDfd5d
2026-11-09 Add CPU_16B and COMPUTER_16B
    Wire the 16-bit blocks into a single-cycle Harvard CPU: register file,
    ALU and shifter with immediate/second-word operand muxes, write-back
    mux, flags from the write-back value and the ALU, data-memory ports
    (address from the ALU, SP or SP-1), stack pointer, PC with absolute,
    register, memory and relative targets, and a synchronous Reset. 20,091
    NANDs; COMPUTER_16B adds a four-digit hex display (20,755).
    Program-flow tests run six programs (arithmetic and 32-bit carry,
    shifts, every branch kind, memory/stack/nested CALL/RET, IN, Fibonacci
    to 46368) against a reference model of the ISA, checking PC, Out, SP,
    flags and every memory access after each clock.
    Co-Aut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
2026-11-09 Add 16-bit assembler, RAM-backed runner and 16-bit example programs
    - isa: Isa enum (Cpu8/Cpu16) with a shared first pass; new CPU_16B
    assembler/disassembler in src/isa/cpu16.rs (two-word LI/JMP/CALL,
    [Rs+off] addressing, branch targets as addresses, signed numbers,
    INC/DEC/SUBI/BRA pseudo instructions, 64K words)
    - machine: Machine struct with ROM, data RAM and input port; port widths
    and the instruction set are detected from the circuit
    - run: COMPUTER_16B by default for programs/16, --input, display and
    trace sized to the ports
    - viewer: examples, assembler and listing follow the built CPU
    - programs/16: fibonacci, multiply, factorial, sort, run to HALT in tests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
2026-11-10 Model external memory timing and add a two-stage pipelined CPU_16B_PIPE
    chip build --mem-delay NS times the instruction and data memories outside
    the chip: Instruction/InstructionNext arrive NS after PC, MemDataIn NS after
    MemAddr (taken from the arrival at the pins), and the memory outputs get a
    buf_4 driver instead of STA's ideal port driver.
    CPU_16B_PIPE / COMPUTER_16B_PIPE split fetch and execute with an
    instruction register (IR_16B, cleared to NOP) and a fetch PC
    (PC_FETCH_16B, branch target = PC + Offset, return address = PC). Same
    ports and ISA; taken jumps cost one clock. Test suites are generated from
    the CPU_16B programs and end in the same state.
    With 3 ns memories: COMPUTER_16B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
2026-11-10 Add three-stage pipelined CPU_16B_PIPE3 with a memory stage
    Fetch | execute | memory: the execute stage registers result, memory
    address, store data and control bits; MemAddr/MemDataOut/MemWrite come
    straight from those registers and the register file is written in the
    memory stage. HAZARD_16B forwards the memory-stage result and stalls one
    clock for load-use; RET takes its target from memory (two lost clocks);
    Halted waits until the memory stage is idle.
    With 3 ns memories and --optimize: 102 MHz at about 1.22 clocks per
    instruction, about 84 instructions per microsecond against 59 for the
    single-cycle COMPUTER_16B. The suites include a hazard program and end in
    the same state as CPU_16B.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
    [machine.rs]
2026-11-10 Add SoC roadmap towards an own board
    From the pipelined 16-bit core to a system with external memory, memory-
    mapped peripherals, caches and finally an FPGA prototype and board.
2026-11-10 Add memory wait states to CPU_16B_PIPE3 and the runner
    IWait (instruction not delivered yet) holds the PC and feeds the execute
    stage a NOP; DWait during a memory-stage access (new output MemRead, plus
    MemWrite) freezes the whole pipeline, keeping MemAddr/MemDataOut/MemWrite
    and blocking register writes. Both are active-high, so unconnected inputs
    keep the old behaviour.
    The runner models N wait states per access (Machine::latency, run
    --mem-latency N). Tests run programs with 0, 1 and 3 wait states, and the
    CLT suites include a program with 2 wait states for verify-verilog.
2026-11-10 Add CPU_16B_SOC with one memory bus for instructions and data
    The three-stage pipeline now shares one memory: Addr, DataIn, DataOut,
    Write, Wait and Fetch (1 = instruction fetch). A memory-stage access takes
    the bus and the fetch waits; Wait during such an access holds the whole
    pipeline. Without InstructionNext, a two-word instruction waits one clock
    in execute until its second word is in IrNext.
    IR_WORD_16B is the one-word instruction register, now also used inside
    IR_16B. The runner plays one shared memory (program from address 0,
    writes visible to later fetches) with wait states per bus access. All
    16-bit program tests also run on COMPUTER_16B_SOC, including code written
    to memory and t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
2026-11-10 Add memory-mapped I/O: SOC_16B with GPIO, display and UART
    IO_16B answers the I/O page 0xF0xx inside the chip: GPIO_OUT, GPIO_IN,
    DISPLAY (4-digit hex display), UART_DATA, UART_STATUS and UART_DIV. The
    UART_TX transmitter sends 8N1 frames with a programmable divider.
    SOC_16B combines CPU_16B_SOC, IO_16B and the display; external memory
    accesses keep the bus pins, I/O accesses never wait and never write
    outside.
    The runner decodes the Tx line into Machine::uart, drives GpioIn from
    --input and prints GpioOut and the UART text; programs/soc/hello.asm runs
    on SOC_16B by default and prints "Hello!".
2026-11-10 Show GPIO and UART of SOC_16B in the viewer
    Circuits with GpioOut/GpioIn get a GPIO section with 16 LEDs and 16
    switches (bit 15 on the left); circuits with a Tx line get a UART console
    with the text received so far. SOC_16B lists the I/O examples from
    programs/soc first, and the example list is now rebuilt on every circuit
    change.
2026-11-10 Group the viewer's circuit list into collapsible sections
    Building blocks are grouped by their directory under src/circuits (new
    CircuitBuilder::category, exposed as Sim::categories); the designs from
    circuits/ are split into computers, CPUs and CPU parts by name. Collapsed
    groups are remembered per browser, the group of the shown circuit opens on
    load, and filtering opens every group with a match.
2026-11-10 Synchronize SOC_16B inputs and test power-on from unknown state
    SYNC<W> is a two-flip-flop synchronizer; SOC_16B passes Reset, GpioIn and
    In through it (two clocks late, Reset held for at least three clocks). The
    runner applies a power-on reset (Machine::reset) before running a program.
    verify-verilog --x-init starts every cell of the exported netlist as x,
    like flip-flops after power-on; SOC_16B, COMPUTER_16B_SOC, CPU_16B_SOC,
    CPU_16B_PIPE3 and UART_TX reach a defined state after reset and behave as
    in our simulator. The SoC roadmap records the timing check of the routed
    SOC_16B (about 98 MHz with extracted parasitics, register-to-register hold
    met) and what is still open.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
    [machine.rs, main.rs, mod.rs]
2026-11-10 Add an instruction-level simulator and benchmarks for the 16-bit CPUs
    isa::sim16::Cpu16 executes the CPU_16B instruction set directly in Rust
    and serves as the reference for the circuits: a test compares Out, SP,
    flags and data memory with COMPUTER_16B on all example programs and
    benchmarks. programs/bench has five small benchmarks (software multiply,
    software divide, branches, memory, recursive calls); `bench` runs them on
    the simulator (instructions) and on each computer (clocks, result must
    match). Baseline: SOC_16B needs 1.41 clocks per instruction.
2026-11-10 Add a multiply/divide unit to CPU_16B_SOC (MULL, MULH, DIVU, MODU)
    MULDIV_16B computes one bit per clock in 16 steps: shift-and-add multiply
    and restoring division share one Kogge-Stone adder and the 32-bit Hi:Lo
    shift register. The new op 7 instructions start the unit in execute, wait
    there until it is done and then write the result like an ALU instruction
    (Z/N from it). The other CPUs still treat op 7 as NOP.
    Assembler, disassembler and isa::sim16 know the instructions; SOC_16B now
    also matches the instruction-level simulator in the tests, including
    memory. New benchmarks mul_hw/div_hw: division 4.4x and the dot product
    1.5x faster on SOC_16B.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
2026-11-10 Add branch prediction to CPU_16B_SOC and take hold logic off the decode path
    The control unit now decodes the instruction register directly; while
    execute waits (load-use stall, Wait, NeedNext, MdWait), only the effects
    are blocked (register and memory writes, flags, SP, Out, jumps and
    branches). Before, the hazard and wait logic sat in front of the control
    unit and thus of the long decode -> ALU -> flags path.
    Static prediction in fetch: a fetched Bcc with a negative offset, or BRA,
    is taken right away (PredAdder); execute only redirects when the
    prediction was wrong (back to AltPc) or a taken branch was not predicted.
    PC_FETCH_16B exposes its incrementer as Next.
    SOC_16B: about 7 % fewer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
2026-11-10 Add a timer and interrupts to the SoC (EI, DI, RETI)
    TIMER_16B in IO_16B (TIMER at 0xF006, TIMER_CTRL at 0xF007) counts down
    once per clock, reloads at 0 and raises Irq while its interrupt is
    enabled, until software acknowledges it.
    CPU_16B_SOC takes an interrupt instead of the instruction in execute when
    Irq and Ie are set and that instruction could run now: it does CALL 0x0002
    with the address of the interrupted instruction (PcE) as return address,
    saves the flags and clears Ie. EI/DI are NOP variants and RETI a RET
    variant (restores the flags, sets Ie), so the control unit is unchanged
    and the other CPUs run them as NOP/RET.
    Example programs/soc/timer.asm; tests include a 32-bit ADD/ADC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
2026-11-10 Add UART receive and byte access (LB, SB) to the SoC
    UART_RX samples each bit in its middle with the transmitter's divider;
    IO_16B gets UART_RX at 0xF008 (reading acknowledges), a receive bit in
    UART_STATUS and UART_CTRL at 0xF009 for a receive interrupt. SOC_16B has an
    Rx pin (synchronized, idles at 1) and tells IO_16B about data reads.
    LB/SB (op 15) use byte addresses: Rs + off3, word = address / 2, the even
    byte is the low one. CPU_16B_SOC decodes them locally; LB picks and
    zero-extends the byte in the memory stage, SB puts the byte on both halves
    and sets the new ByteEn outputs so only that byte is written.
    The runner drives Rx from Machine::uart_in (run --uart-in) and honours
    ByteEn;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
2026-11-10 Hide the chip message when leaving the 3D view
    The message ("no layout yet", "WebGL not available") sits above the
    canvas, outside the 3D area, so it stayed over the schematic after
    switching to another view mode. leaveChip() now clears it, and a CSS
    rule hides it outside chip mode in case the async layout lookup shows it
    after the switch.
2026-11-10 Add a 16-word instruction cache to the SoC
    ICACHE_16 (direct mapped, one word per entry, in flip-flops) lets the
    fetch of CPU_16B_SOC go on without the bus when it hits, so it no longer
    waits while the memory stage uses the bus or the memory has wait states.
    Every word the bus delivers to the fetch fills the cache; a store
    invalidates the entry of its address (second tag port at the bus
    address), and a word being stored right now is not taken from the cache.
    A plain prefetch buffer was measured first: the shared bus is busy almost
    every clock, so it would gain only ~1-3 %. With the cache the benchmarks
    take 7,297 instead of 7,699 clocks, and 10,045 instead of 20,809 with two
    wait states per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
2026-11-10 Simulate the basic gates in Rust, keep their NAND versions
    NAND, NOT, AND, AND3, OR, NOR, NOR4, XOR and XNOR - the cells a CMOS
    process offers directly - are now built-in gates (src/circuit/gates.rs)
    that the simulator evaluates in Rust. Their CLDL definitions are kept,
    built from NAND gates only and renamed to <NAME>_NAND in
    src/circuits/nand/ with their tests.
    The NAND count, the NAND and transistor views, the logic depth and the
    NAND netlist export replace each built-in gate by its NAND definition, so
    they are unchanged; in the viewer the wires inside a gate are computed
    from its inputs. `test --nand` builds every circuit from NAND gates only
    as a cross-check, and a unit test compares ev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
    [lib.rs, main.rs, mod.rs]
2026-11-10 Count basic blocks instead of NANDs in the viewer
    The simulator runs on the built-in gates, so the circuit list, the part
    nodes and the status line of the parts view now show basic blocks
    (built-in gates and multi-bit blocks, as drawn in the basic-block view);
    the NAND count stays in the list's tooltip and in the NAND and
    transistor views. CircuitBuilder::block_count matches the basic-level
    flattening for every circuit (checked in the existing count test).
2026-11-10 Build big circuits fast and show a loading overlay in the viewer
    Each INIT block (every flip-flop primes itself with three clock pulses)
    evaluated all gates built so far, so building was quadratic in the
    number of flip-flops: SOC_16B took 4.7 s in the viewer. An INIT now
    evaluates only its own part's gates (its subtree in build order), which
    is what it sets up: SOC_16B builds in 0.28 s. Initial states are
    unchanged (all CLT suites, cargo test, verify-verilog with its INIT
    values from the built state, --x-init and test --nand).
    The viewer shows a loading overlay with a spinner while a big circuit
    is built (more than 3,000 basic blocks) or a big flattened view is laid
    out; it blocks clicks me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
2026-11-10 Tidy up the viewer and give chip builds their own window
    The view mode (as segmented buttons), the clock and rebuild buttons and
    the bit-stripe toggle move from the sidebar into the header. The Verilog
    export becomes a menu with labelled entries (basic blocks or NAND gates,
    sky130 or generic cells) instead of depending on the current view.
    Chip builds get a floating, draggable window: the OpenROAD options (now
    also clock target and memory delay), the run it builds into, a spinner
    with the tail of the OpenROAD log, the result, and the design's layouts
    with their key numbers and a button to show them in Chip 3D. A build
    keeps running when the window is closed; a dot on the header button
    shows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
2026-11-10 Use the Kogge-Stone adder in the timer and UARTs
    The critical path of SOC_16B at 7 ns ran through the ripple adder
    UART_RX.FirstWait. The four 16-bit ripple adders of the peripherals are
    now ADDER_CLA_16B, as in the CPU: 143 -> 156 MHz. The new critical path
    is the single-cycle fetch loop.
2026-11-10 Measure where the clocks go and how long each path is
    bench --stalls attributes every clock of a CPU_16B_SOC to an executed
    instruction or to the cause of the lost clock (load-use, bus busy, second
    word, jumps, RET, branches, MUL/DIV, wait states), read from the internal
    wires. The chip flow also writes endpoints.txt with the worst path to
    every endpoint. ROADMAP_SOC.md has the results and what a deeper
    pipeline would gain.
    [lib.rs, main.rs, stalls.rs]
2026-11-10 Faster shifter and OR_WIDE: SOC_16B at 171 MHz
    SHIFTER_16B is now a rotator (ROT_STAGE, left rotation as right rotation
    by 16 - n through the stage selects) plus a mask built alongside: the
    word passes 5 muxes instead of 7. A new test checks it against the
    instruction-level shifts for every operation and amount. OR_WIDE ends
    in a NAND instead of AND + NOT.
    ROADMAP_SOC.md also estimates what a 5-stage pipeline would gain.
2026-11-10 Add the 5-stage timing model experiment
    CPU_16B_SOC5 (with CONTROL_REG_16B) and SOC_16B5 put pipeline registers at
    the stage boundaries of a 5-stage pipeline to measure its clock; the
    hazard and branch logic is not adapted, so they do not run programs.
    SOC_16B3S checks the registered I/O select on the 3-stage design.
    ROADMAP_SOC.md has the results: 228 MHz (hd) / 331 MHz (hs), but the
    extra branch cost leaves 0.96-1.11x of the 3-stage speed.
2026-11-10 Simulate about 100x faster: flat wires, built-in flip-flops, topological order
    The simulator kept every wire as an Rc<RefCell> and swept all gates in
    build order until nothing changed; DFLIP_FLOP was two latches with
    feedback, so a clock took many full sweeps. SOC_16B ran at about 100
    clocks per second.
    Now every wire is an index into one value array and gates are compact
    structs. DFLIP_FLOP is simulated as one built-in rising-edge flip-flop
    (the latch version stays for the NAND views, counts and build_latches).
    After the build the gates are grouped into strongly connected components
    and sorted topologically; feedback loops (SR latches) are iterated as a
    group. A wire change marks the gates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
    [lib.rs, machine.rs, main.rs, mod.rs]
2026-11-10 Add the 32-bit RISC-V SoC (SOC_RV32, RV32IM + Zicsr)
    A RISC-V SoC built from the same gates as SOC_16B, separate from the 8/16-bit
    designs (circuits/riscv/, src/riscv/, programs/riscv/); decisions and
    measurements in ROADMAP_32BIT.md.
    - Tools: instruction table (decode/encode/disassemble), a GNU-syntax
    assembler with pseudo-instructions, directives and local labels (checked
    against LLVM), and an instruction-level simulator with traps, interrupts
    and the SoC's peripherals.
    - Shared blocks with a width parameter: ADDER_KS5<W>, REG_FILE_32<W>,
    MUX_32_1_BUS<W>, DECODER_3_8, DECODER_5_32.
    - CPU_RV32: three stages (fetch | execute | memory) with forwarding and a
    load-use stall on one bu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
    [asm.rs, cli.rs, cpu_tests.rs, isa.rs, lib.rs, machine.rs, main.rs, mod.rs]
2026-11-10 Add .clt tests for the RISC-V circuits and bus values in CLT
    CLT can now set and assert a whole bus at once: `SET A[31:0] 0x1234_5678`,
    `ASSERT S[3:0] 0b1010`, `B[11:0] -5` (two's complement), up to 128 bits.
    Each bus value expands to one pin value per bit.
    The new suites cover the shared 32-bit blocks (ADDER_KS5, DECODER_3_8,
    DECODER_5_32, MUX_32_1_BUS, REG_FILE_32) and every RV32 part, plus program
    runs on CPU_RV32 and SOC_RV32. They are generated from the simulator by
    `cargo test --release --lib riscv::clt_gen -- --ignored` and pass on the
    gate and NAND level and in verify-verilog (basic, --keep-latches, nand).
    Claude-Session: http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
2026-11-10 Shorten the RV32 execute critical path from 131 to 98 NAND levels
    - The load/store alignment check takes (rs1 + imm)[1:0] from its own
    2-bit adder instead of the ALU result.
    - A taken branch is misaligned when imm[1] is set (PcE is word-aligned),
    so only the branch condition is on the exception path; jal/jalr still
    use the target adder.
    - minstret counts with a constant carry-in and loads on Retire, so the
    commit signal no longer runs through the 64-bit carry chain.
    - CSR writes, mret and ebreak commit without waiting for the ALU and
    branch exceptions (they can only fail as illegal instructions).
    Claude-Session: https://claud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
2026-11-10 Build MUX_2_1 as NAND-NAND (2 instead of 4 NAND levels)
    Out = NAND(NAND(A, NOT S), NAND(B, S)) instead of AND-OR. Every circuit
    built from multiplexers gets shorter and smaller:
    - CPU_RV32/SOC_RV32: 98 -> 84 NAND levels, 123,329 -> 100,945 NANDs
    - SOC_16B: 85 -> 64 levels, 70,327 -> 56,151 NANDs
    - CPU_16B_PIPE: 78 -> 60 levels
    - COMPUTER_8B: 8,064 -> 6,352 NANDs
    Claude-Session: https://claude.ai/code/session_01RCZzuKfhWVCxCdgEwSa2hc
2026-11-10 Shorten the RV32 critical path further to 69 NAND levels
    - BRANCH_RV32: the branch condition gets its own comparator on the
    forwarded rs1/rs2, so the immediate and operand muxes of the ALU are
    off the branch path.
    - CONTROL_RV32 decodes the immediate formats straight from the opcode
    bits (exact for every legal opcode) instead of via the opcode decoder.
    - The late branch exception joins the exception OR at its end.
    The longest paths are now balanced at 65-69 levels (decode -> load-use
    stall -> CSR write, branch compare -> redirect -> PC, trap -> mstatus).
    The shifter (17) and register file read (14) are no longer on them.
    ROADMAP_32BIT.md gets a phase 7 with the steps and measurements.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
    [clt_gen.rs, tests.rs]
2026-11-11 Shifter without bit reversal, mtval address from the adder
    SHIFTER_RV32 is now a left and a right shifter side by side (five mux
    stages each, new SHIFT_STAGE_L/SHIFT_STAGE_R) with outputs Shl and Shr;
    the ALU's result mux picks one, so the two bit-reversal muxes are gone.
    ALU_RV32 also outputs the adder sum, which the CPU takes as mtval for a
    misaligned load/store instead of the full ALU result.
    sky130 (--optimize, 7 ns): 131 -> 134 MHz; the branch -> PC and
    ALU -> ResultM paths are now within 0.02 ns of each other.
    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
    [clt_gen.rs]
2026-11-11 Replace adders used as incrementers and comparators with cheaper blocks
    - INC_KS5<W>: Kogge-Stone incrementer (A + Cin), for mcycle/minstret,
    mtime, the MulDiv sign handling and PC + 4.
    - CMP_KS5<W>: carry-only comparator (Eq from the AND of the propagate
    bits, Lt/Ltu from the carry), for BRANCH_RV32 and mtime >= mtimecmp.
    Prototyped by a research subagent; SOC_RV32 -6.4k NANDs, depth unchanged.
    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
2026-11-11 Radix-4 MulDiv and static branch prediction at fetch
    - MULDIV_RV32 handles 2 bits per clock for multiply and divide (18 instead
    of 34 clocks): three adders form X+-M, X+-2M, X+-3M in parallel (3M via
    one carry-save row); a multiply picks the multiple from Lo[1:0], a
    divide the largest one that does not borrow. Interface unchanged.
    - CPU_RV32 predicts at fetch: backward branches taken, forward not, jal
    always (own PC + imm adder, FTgt). Execute only checks the direction
    (the prediction is XORed into the comparator's funct3 bit); a wrongly
    predicted taken branch redirects to PcE + 4. Targets with imm[1] = 1
    are not predicted, so execute still raises the exception.
    Prototyped by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
2026-11-11 RV32: read registers and pre-decode in fetch (sky130 135 -> 170 MHz)
    - CPU_RV32: rs1/rs2 are read in fetch into OpA/OpB (write bypass on the
    same edge, HazR marks operands to forward from the memory stage)
    - DECODE_RV32: CONTROL_RV32 + IMM_RV32 decode the fetched word into
    registers; execute gets every control signal from flip-flops
    - Redirect no longer waits for the late misaligned-branch exception
    (a misaligned taken branch redirects anyway, TrapMux picks mtvec)
    - IO_RV32: MTIP registered; reads take two clocks (Wait, latched read
    data) so the I/O read mux is off the fetch/decode path; SOC_RV32 muxes
    Wait between external memory and I/O
    - New test for misaligned branch/jal target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
    [clt_gen.rs, cpu_tests.rs]
2026-11-11 viz: open parts in place in the parts view
    A double click on a part now opens it inside the drawing: it becomes a
    labelled frame (name and type in a title bar) with its inner parts, and
    its pins stay on the frame so the outer wires keep their connections.
    A double click on the title bar closes it again; Ctrl+double click still
    shows the part as its own level.
    A "Tiefe" dropdown in the header (only in the parts view, also ?depth=N)
    opens all parts down to that depth. Opening by depth stops at 1200 parts
    so the hierarchical ELK layout stays fast; the status line says when.
    Claude-Session: https://claude.ai/code/session_01RCZzuLQeQq7SBUi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
2026-11-11 viz: lay out opened parts per level, in workers, drawn on zoom
    The parts view laid out a drawing with opened parts as one big ELK graph
    (INCLUDE_CHILDREN), so opening by depth was capped at 1200 parts.
    - Each level is laid out on its own, bottom-up: an opened part is laid out
    first with its pins on the frame border, then placed in its parent like a
    closed part with fixed pins. Instances of a type with the same parts open
    inside share one layout; toggling a part only re-lays the levels above.
    - Levels with more than 150 wires use Brandes-Koepf node placement
    (CPU_16B: 1.4 s -> 0.3 s).
    - ELK runs in up to 4 web workers, so independent levels are laid out in
    parallel and the page sta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
